Nebojsa44/Instrumented-platform/SOLID/0.0.459.26.sldasm

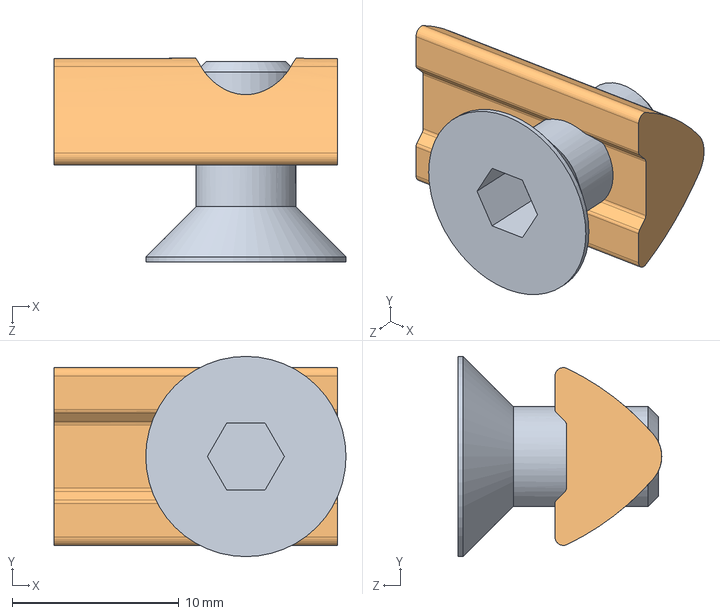
[picture p1: CAD file, 2019-02-13]
SOLID/0.0.459.26.sldasm
17.5 x 12.0 x 12.2 mm
