Nebojsa44/Instrumented-platform/SOLID/Hand.SLDASM

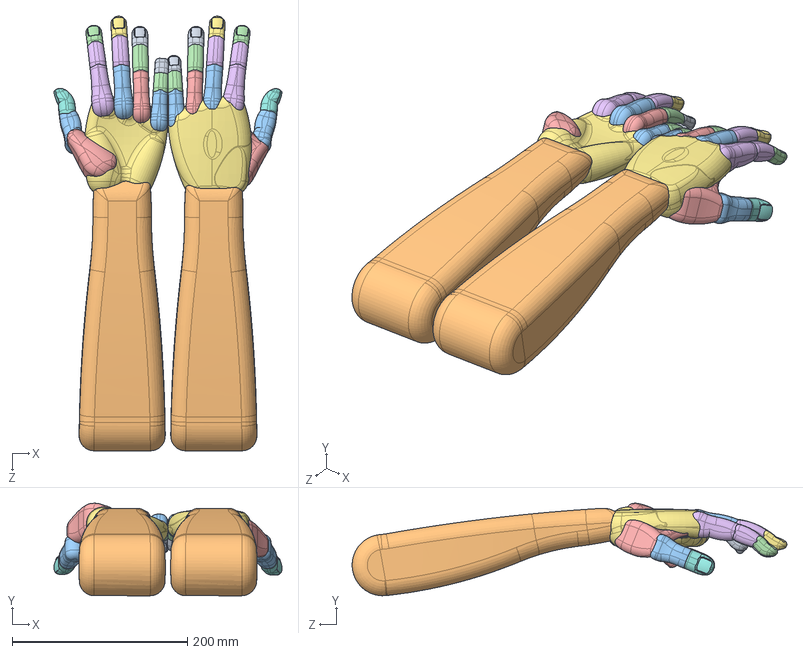
[picture p2: CAD file, 2019-02-13]
SOLID/Hand.SLDASM
260.0 x 105.6 x 495.8 mm
Kugelgelenk-Z_Standard x 2
Kugelgelenk-M_Standard x 2
D2_Standard x 2
Z1_Standard x 2
R3_Standard x 2
Z2_Standard x 2
HF-5d_Standard x 2
Kugelgelenk-R_Standard x 2
K1_Standard x 2
Unterarm-V2_Standard x 2
K3_Standard x 2
K2_Standard x 2
D3d_Standard x 2
M2_Standard x 2
Kugelgelenk-H_Standard x 2
D1_Standard x 2
R1_Standard x 2
Kugelgelenk-K_Standard x 2
M3_Standard x 2
R2_Standard x 2
Kugelgelenk-D_Standard x 2
Z3_Standard x 2
M1_Standard x 2
