Nebojsa44/Instrumented-platform/SOLID/O-1637-016.SLDASM

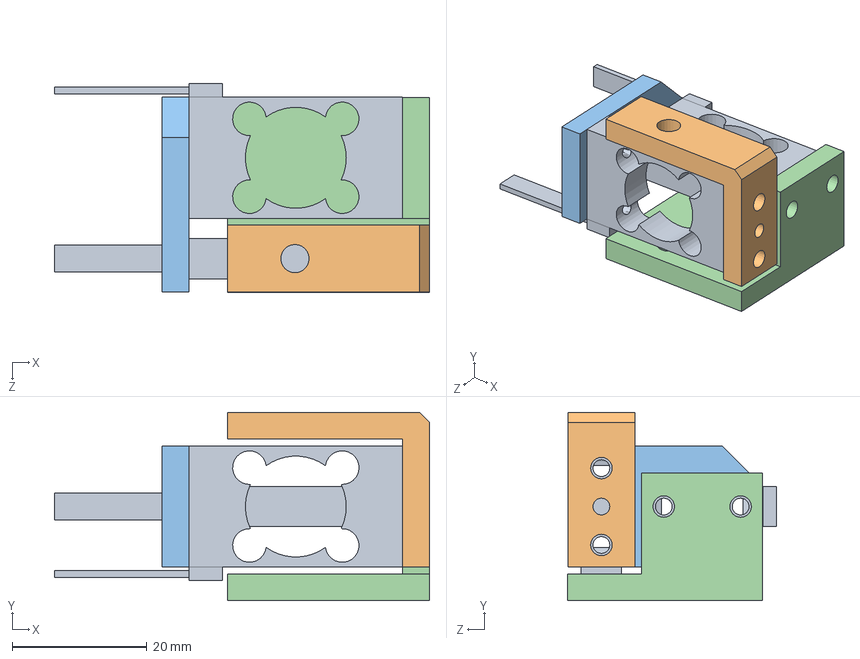
[picture p3: CAD file, 2019-02-13]
SOLID/O-1637-016.SLDASM
55.8 x 28.0 x 31.0 mm
SMD2387-M2-100 x 2
O-1637-004
O-1637-015
O-1637-017
