Nebojsa44/Instrumented-platform/SOLID/O-1637-010.SLDASM

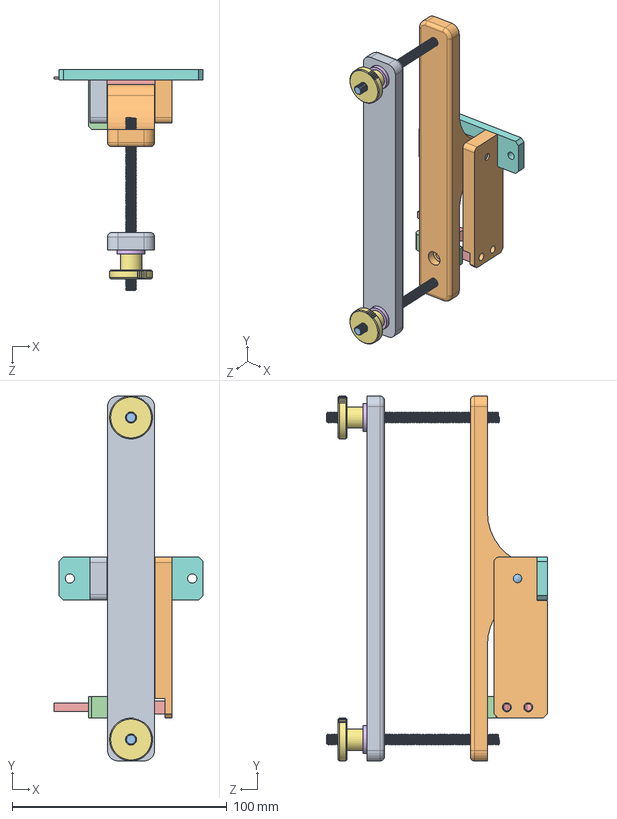
[picture p4: CAD file, 2019-02-13]
SOLID/O-1637-010.SLDASM
69.4 x 170.0 x 103.0 mm
O-1637-012
O-1637-013
GS A4 M5 x 2
O-1637-021
SMD2387-M2-500
DIN172_5-20x10x10 x 2
DIN466_A2_M5 x 2
O-1637-022
O-1637-023
O-1637-024
DIN7_4x36
