Nebojsa44/Instrumented-platform/SOLID/O-1637-007.SLDASM

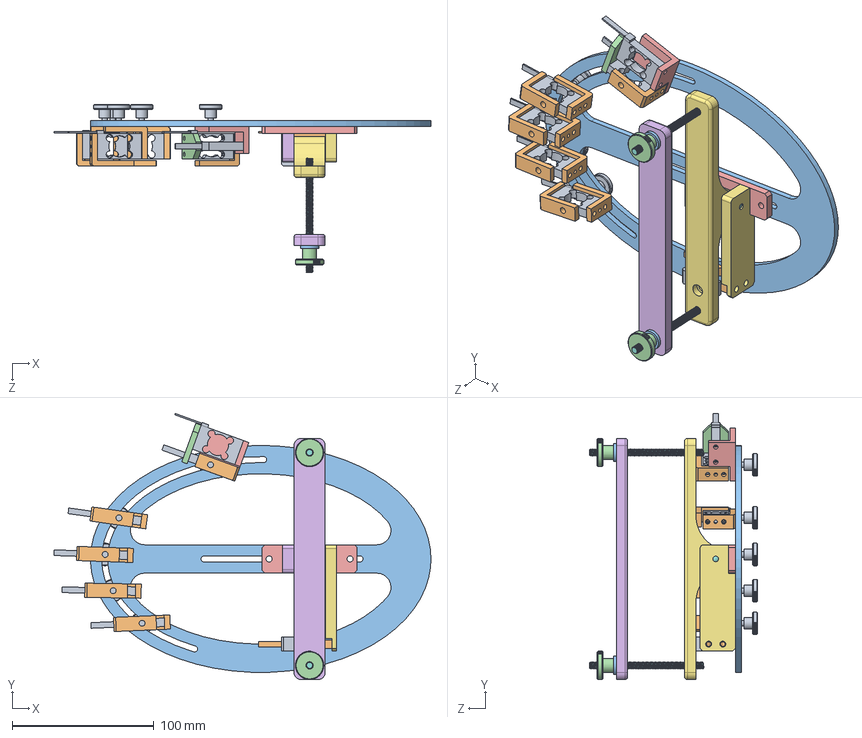
[picture p5: CAD file, 2019-02-13]
SOLID/O-1637-007.SLDASM
265.7 x 187.5 x 118.5 mm
SMD2387-M2-100 x 6
O-1637-004 x 9
O-1637-005
O-1637-015
O-1637-017
O-1637-012
O-1637-013
GS A4 M5 x 2
O-1637-021
SMD2387-M2-500
DIN172_5-20x10x10 x 2
DIN466_A2_M5 x 2
O-1637-022
O-1637-023
O-1637-024
DIN7_4x36
DIN464_A2_M4x8 x 5
