Nebojsa44/Instrumented-platform/SOLID/O-1637-018.SLDASM

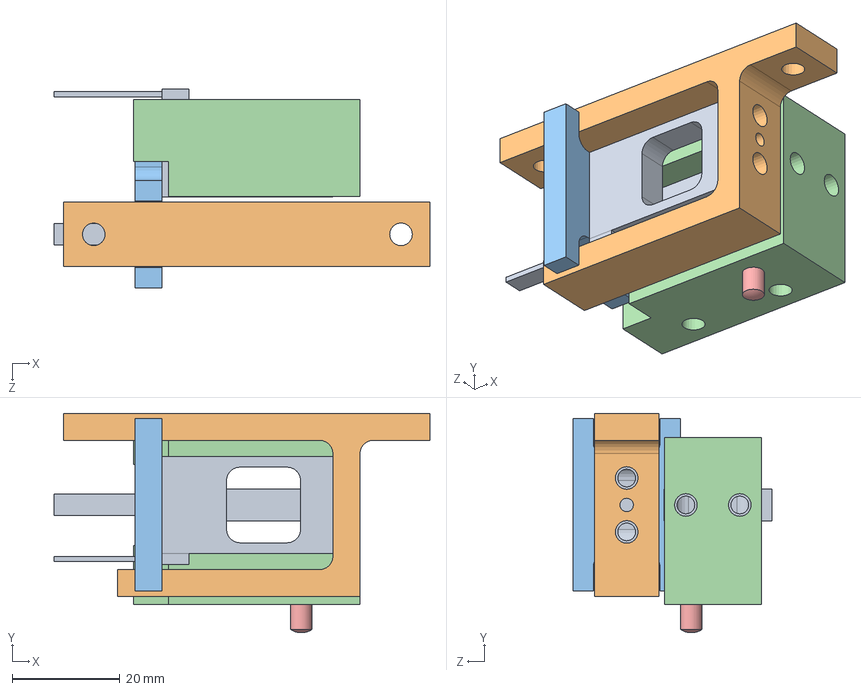
[picture p6: CAD file, 2019-02-13]
SOLID/O-1637-018.SLDASM
69.8 x 40.7 x 37.0 mm
SMD2387-M2-500 x 2
O-1637-014
O-1637-020
O-1637-019
DIN7_4x10
