Nebojsa44/Instrumented-platform/SOLID/O-1637-001.SLDASM

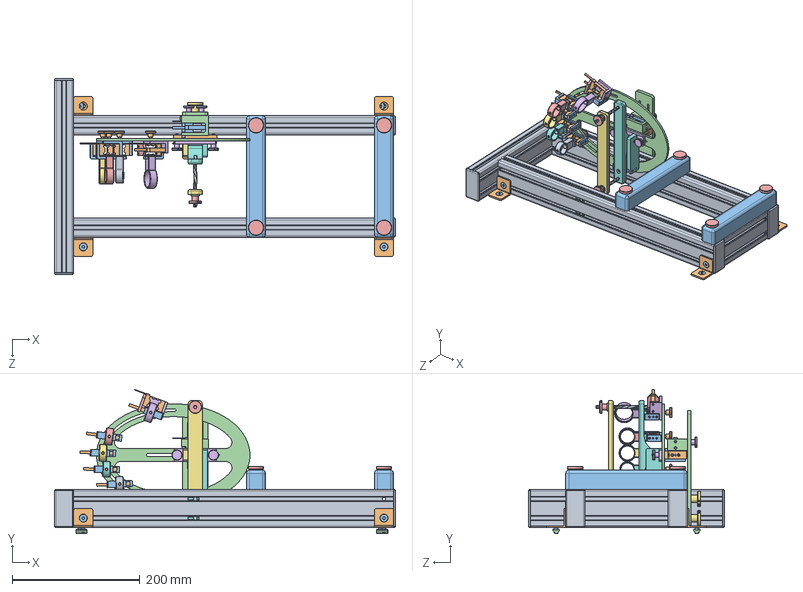
[picture p7: CAD file, 2019-02-13]
SOLID/O-1637-001.SLDASM
533.0 x 225.3 x 306.0 mm
O-1637-002
SMD2387-M2-100 x 6
O-1637-004 x 9
O-1637-005
O-1637-015
O-1637-017
O-1637-012
O-1637-013
GS A4 M5 x 2
O-1637-021
SMD2387-M2-500 x 3
DIN172_5-20x10x10 x 2
DIN466_A2_M5 x 2
O-1637-022
O-1637-023
O-1637-024
DIN7_4x36
DIN464_A2_M4x8 x 5
O-1637-008 x 2
O-1637-009
O-1637-026
O-1637-006
O-1637-027
O-1637-028
O-1637-029
O-1637-014
O-1637-020
O-1637-019
DIN7_4x10
DIN464_A2_M4x16 x 4
DIN464_A2_M6x16 x 2
DIN464_A2_M6x30 x 4
