Nebojsa44/Instrumented-platform/SOLID/O-1637-003.SLDASM

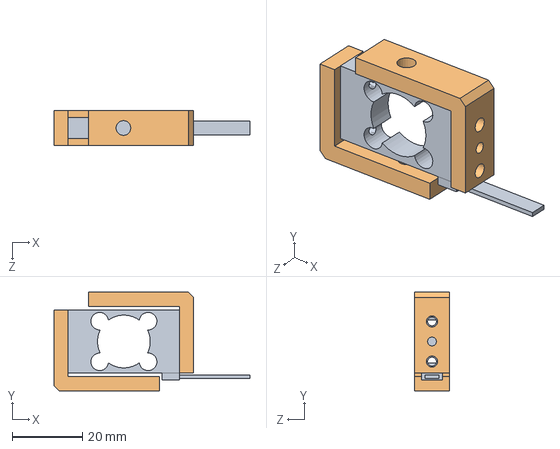
[picture p8: CAD file, 2019-02-13]
SOLID/O-1637-003.SLDASM
55.8 x 28.0 x 10.0 mm
SMD2387-M2-100
O-1637-004 x 2
