Nebojsa44/Instrumented-platform/SOLID/O-1637-025.SLDASM

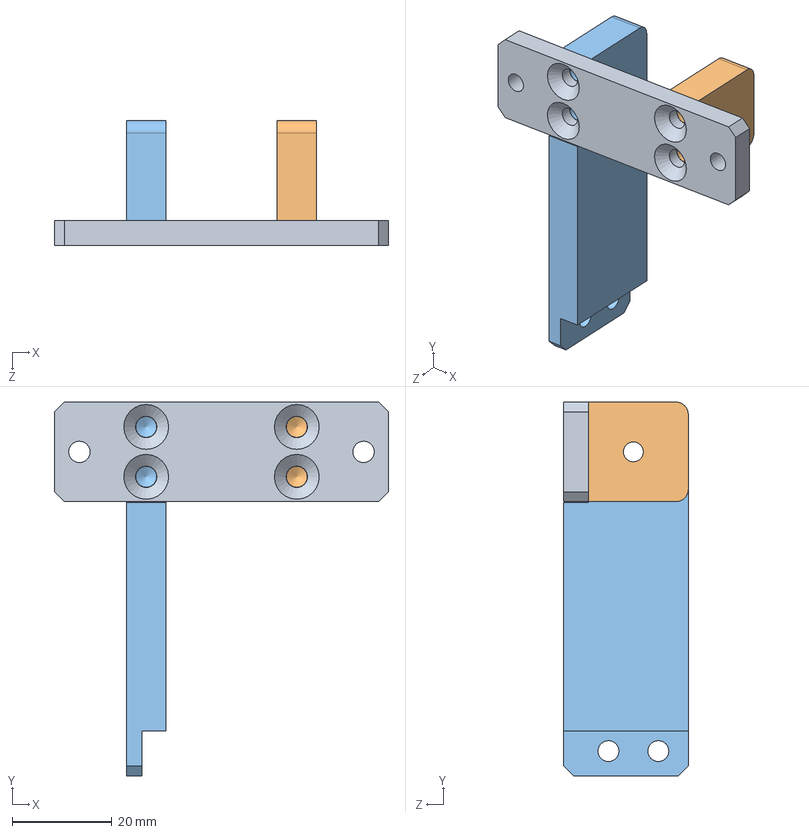
[picture p9: CAD file, 2019-02-13]
SOLID/O-1637-025.SLDASM
67.0 x 75.0 x 25.0 mm
O-1637-022
O-1637-023
O-1637-024
