Nebojsa44/Instrumented-platform/SOLID/GS A4 M5.SLDPRT

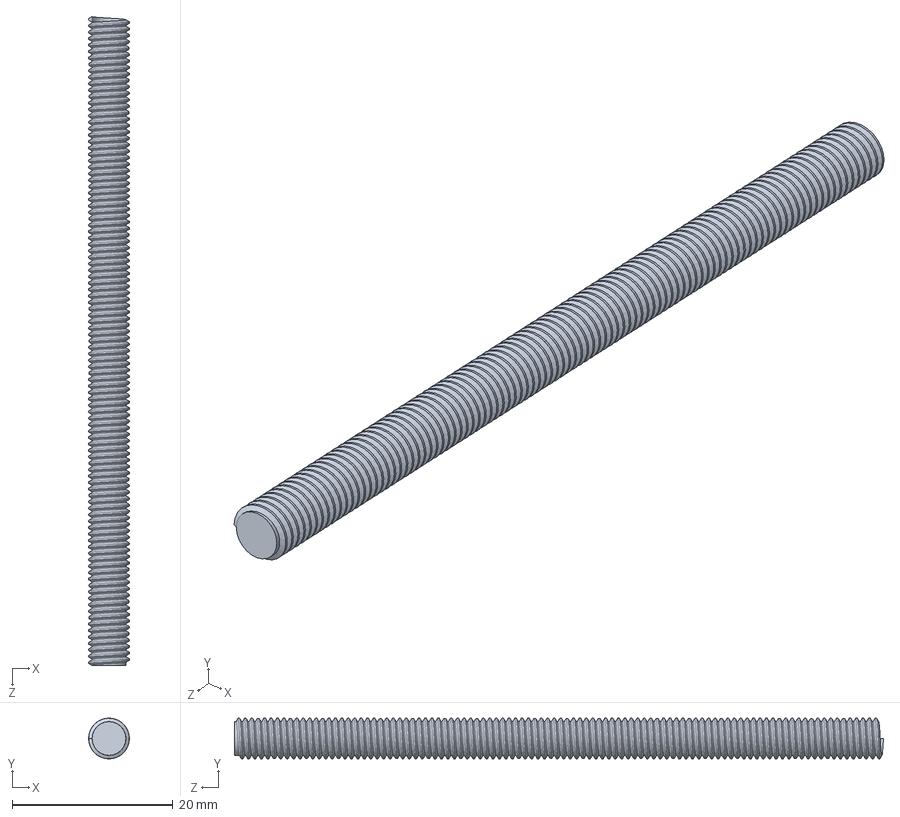
[picture p10: CAD file, 2019-02-13]
SOLID/GS A4 M5.SLDPRT
5.07 x 5.07 x 80.7 mm
