Nebojsa44/Instrumented-platform/SOLID/0.0.419.40.sldprt

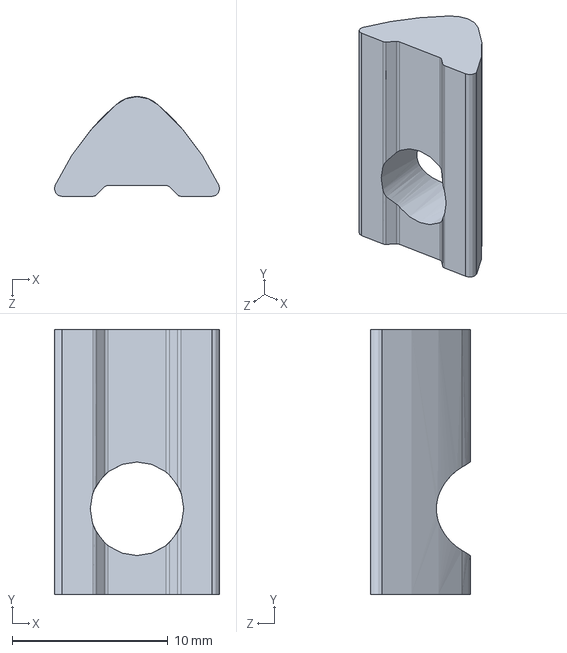
[picture p11: CAD file, 2019-02-13]
SOLID/0.0.419.40.sldprt
10.6 x 17.0 x 6.40 mm
