Nebojsa44/Instrumented-platform/SOLID/0.0.419.23.sldprt

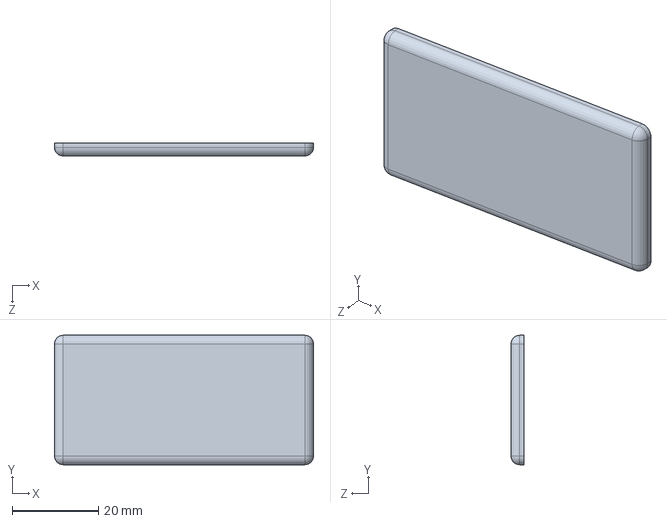
[picture p12: CAD file, 2019-02-13]
SOLID/0.0.419.23.sldprt
60.0 x 30.0 x 3.00 mm
