Nebojsa44/Instrumented-platform/SOLID/SMD2387-M2-100.SLDPRT

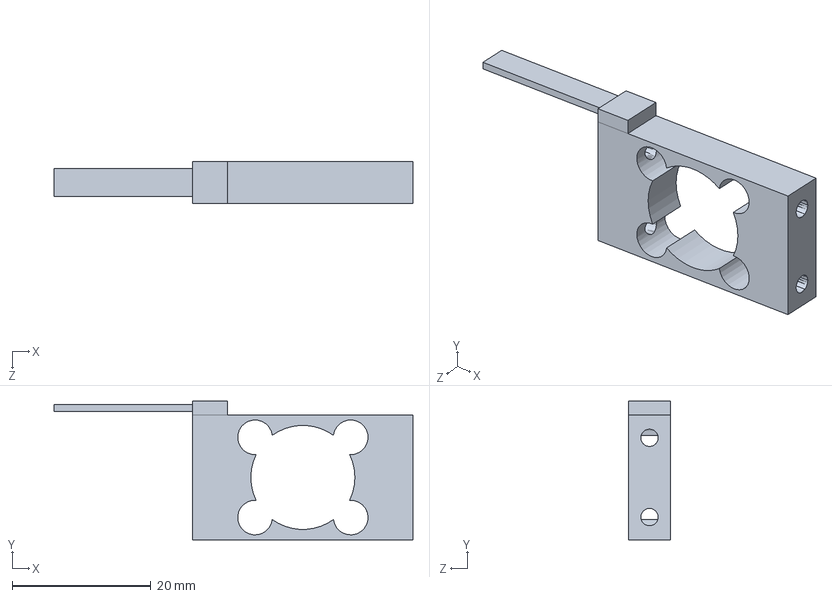
[picture p13: CAD file, 2019-02-13]
SOLID/SMD2387-M2-100.SLDPRT
51.8 x 20.0 x 5.99 mm
