Nebojsa44/Instrumented-platform/SOLID/SMD2387-M2-500.SLDPRT

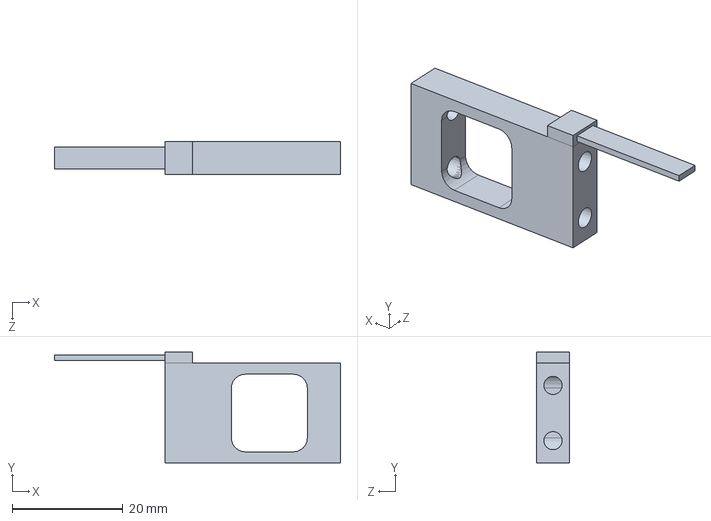
[picture p14: CAD file, 2019-02-13]
SOLID/SMD2387-M2-500.SLDPRT
51.8 x 20.0 x 5.99 mm
