Nebojsa44/Instrumented-platform/SOLID/0.0.459.12.sldprt

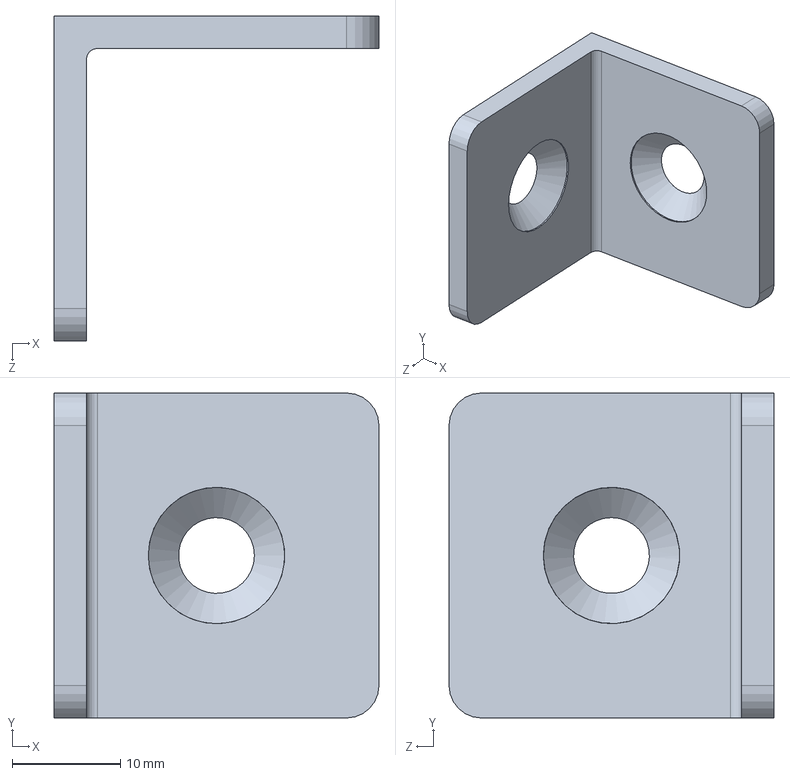
[picture p15: CAD file, 2019-02-13]
SOLID/0.0.459.12.sldprt
30.0 x 30.0 x 30.0 mm
