Nebojsa44/Instrumented-platform/SOLID/DIN7_4x10.SLDPRT

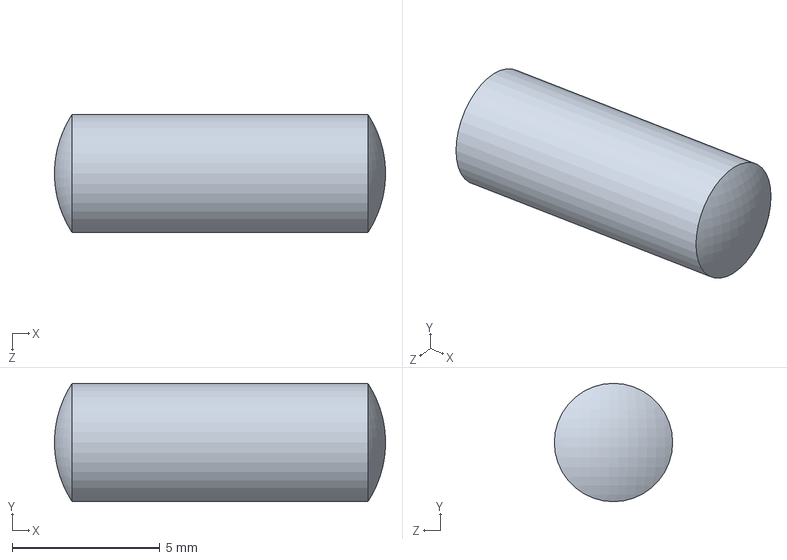
[picture p16: CAD file, 2019-02-13]
SOLID/DIN7_4x10.SLDPRT
11.2 x 4.00 x 4.00 mm
