Nebojsa44/Instrumented-platform/SOLID/DIN7_4x36.SLDPRT

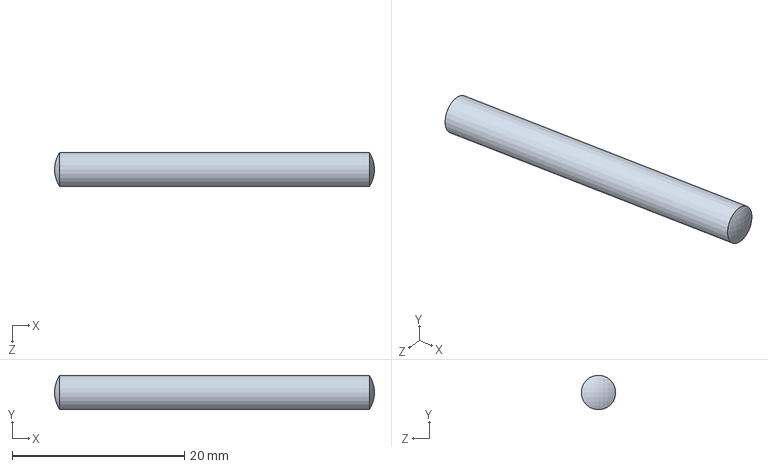
[picture p17: CAD file, 2019-02-13]
SOLID/DIN7_4x36.SLDPRT
37.2 x 4.00 x 4.00 mm
