Nebojsa44/Instrumented-platform/SOLID/O-1637-022.SLDPRT

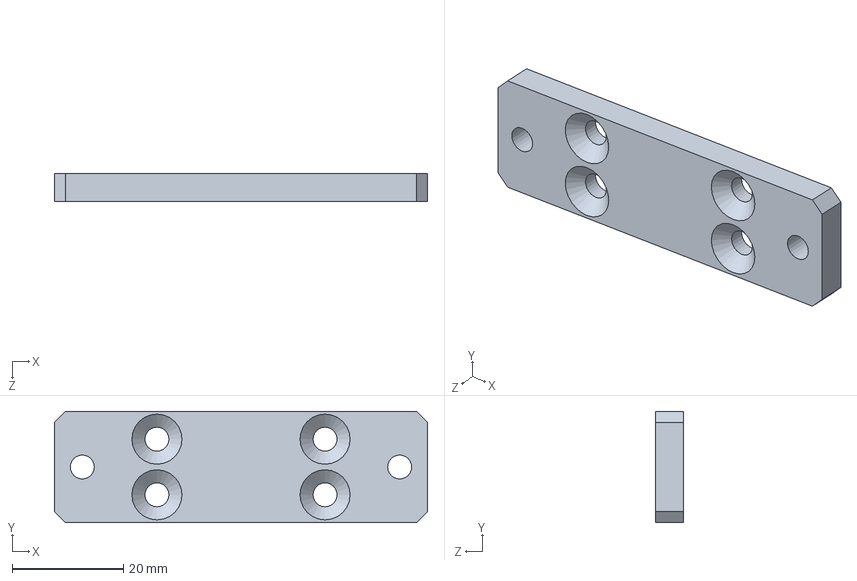
[picture p18: CAD file, 2019-02-13]
SOLID/O-1637-022.SLDPRT
67.0 x 20.0 x 5.00 mm
