Nebojsa44/Instrumented-platform/SOLID/O-1637-019.SLDPRT

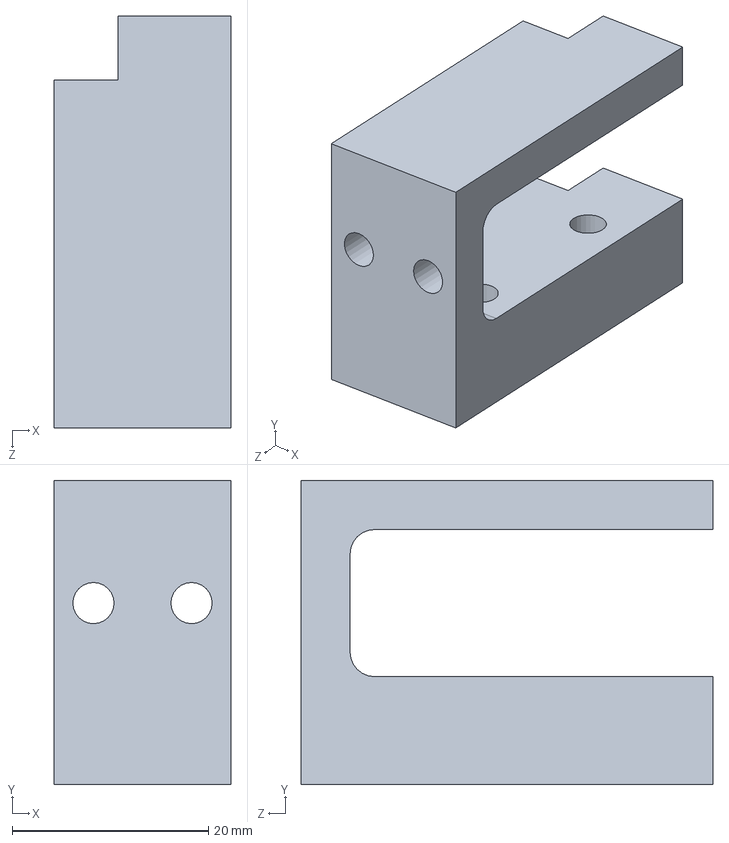
[picture p19: CAD file, 2019-02-13]
SOLID/O-1637-019.SLDPRT
18.0 x 31.0 x 42.0 mm
