Nebojsa44/Instrumented-platform/SOLID/O-1637-012.SLDPRT

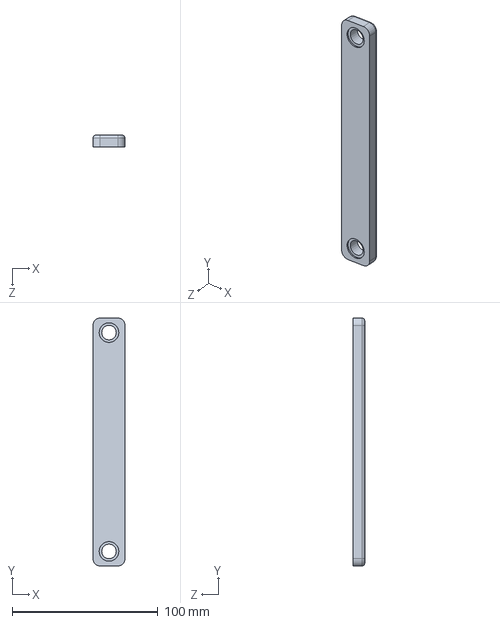
[picture p20: CAD file, 2019-02-13]
SOLID/O-1637-012.SLDPRT
22.0 x 170.0 x 8.00 mm
