Nebojsa44/Instrumented-platform/SOLID/O-1637-021.SLDPRT

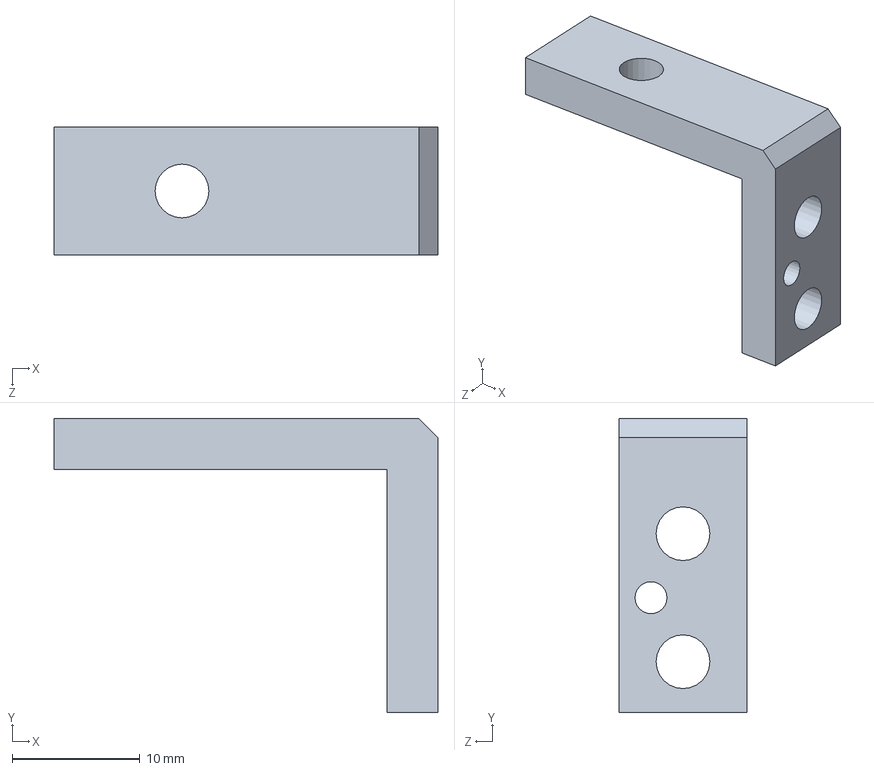
[picture p21: CAD file, 2019-02-13]
SOLID/O-1637-021.SLDPRT
30.0 x 23.0 x 10.0 mm
