Nebojsa44/Instrumented-platform/SOLID/O-1637-023.SLDPRT

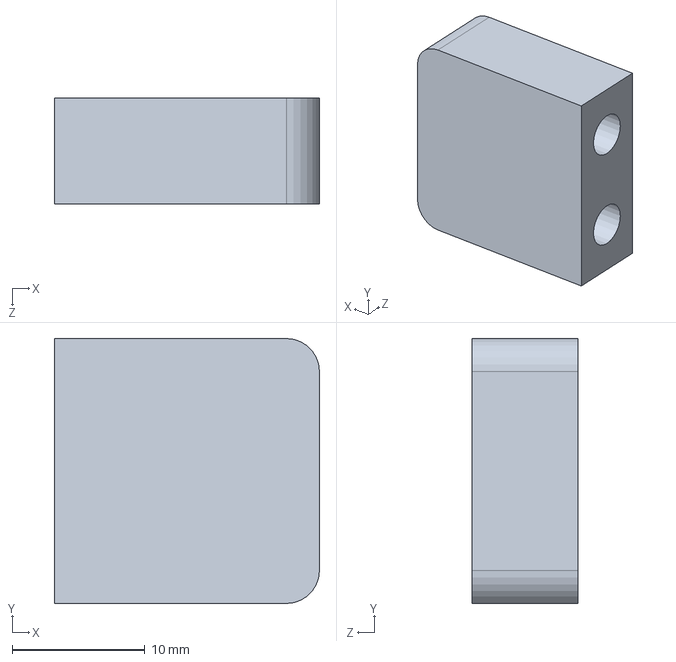
[picture p22: CAD file, 2019-02-13]
SOLID/O-1637-023.SLDPRT
20.0 x 20.0 x 8.00 mm
