Nebojsa44/Instrumented-platform/SOLID/O-1637-015.SLDPRT

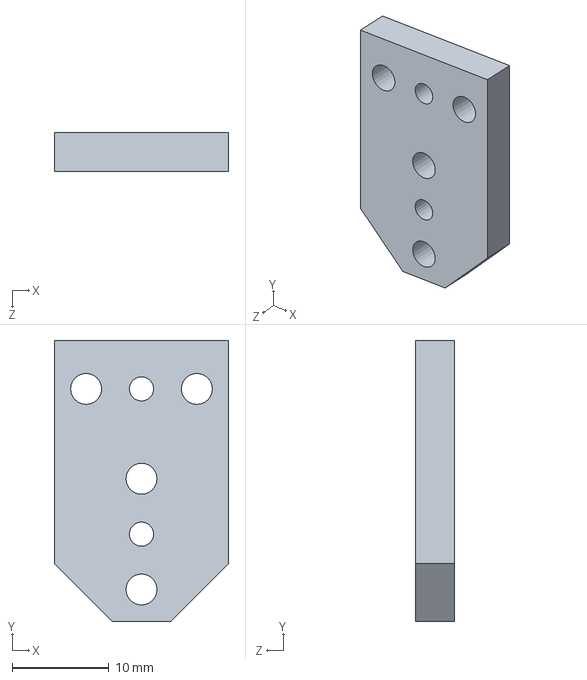
[picture p23: CAD file, 2019-02-13]
SOLID/O-1637-015.SLDPRT
18.0 x 29.0 x 4.00 mm
