Nebojsa44/Instrumented-platform/SOLID/O-1637-037.SLDPRT

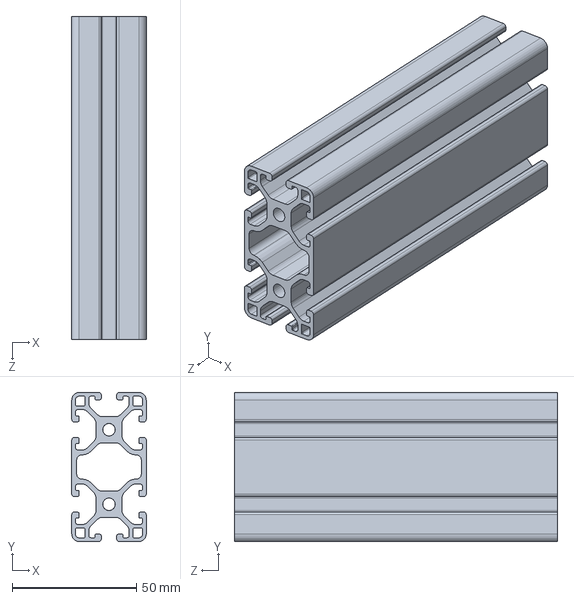
[picture p24: CAD file, 2019-02-13]
SOLID/O-1637-037.SLDPRT
30.0 x 60.0 x 130.0 mm
