Nebojsa44/Instrumented-platform/SOLID/O-1637-035.SLDPRT

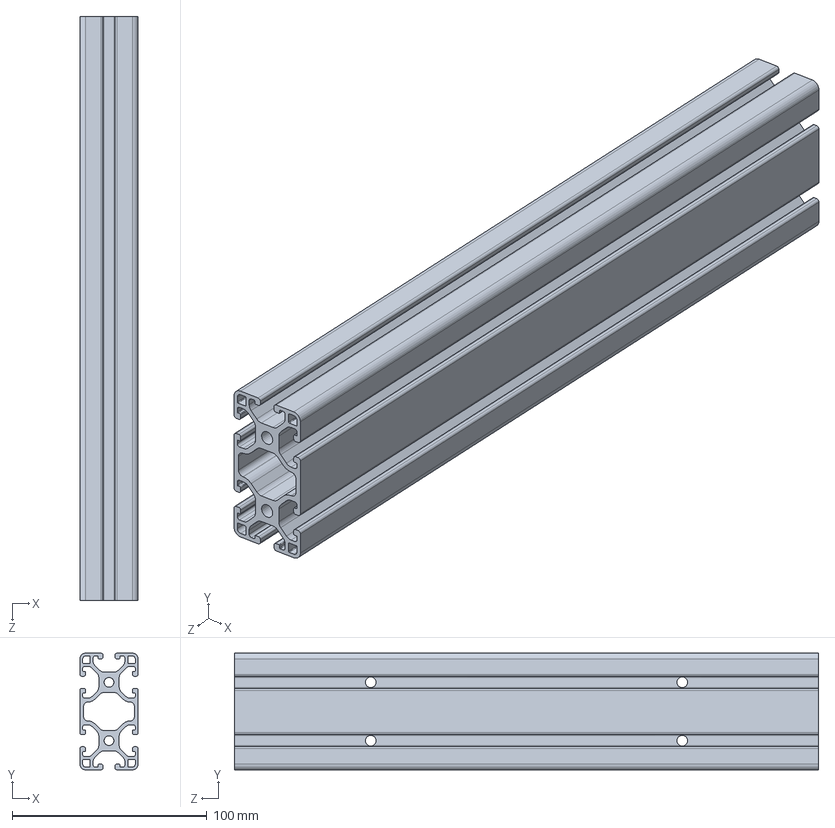
[picture p25: CAD file, 2019-02-13]
SOLID/O-1637-035.SLDPRT
30.0 x 60.0 x 300.0 mm
