Nebojsa44/Instrumented-platform/SOLID/O-1637-036.SLDPRT

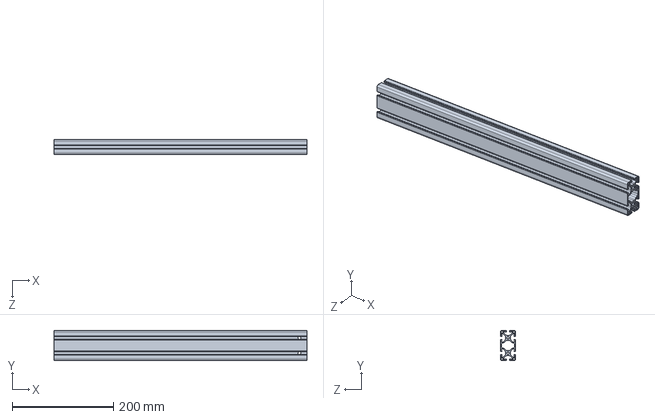
[picture p26: CAD file, 2019-02-13]
SOLID/O-1637-036.SLDPRT
500.0 x 60.0 x 30.0 mm
