Nebojsa44/Instrumented-platform/SOLID/O-1637-005.SLDPRT

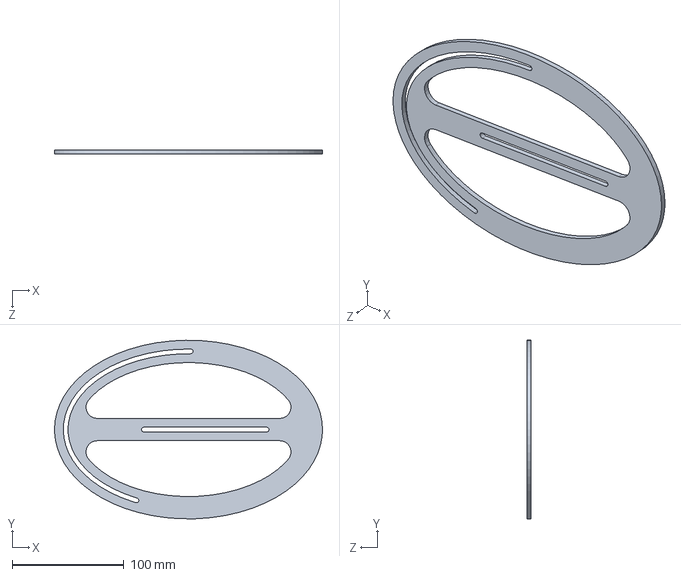
[picture p27: CAD file, 2019-02-13]
SOLID/O-1637-005.SLDPRT
240.0 x 159.9 x 4.00 mm
