Nebojsa44/Instrumented-platform/SOLID/O-1637-013.SLDPRT

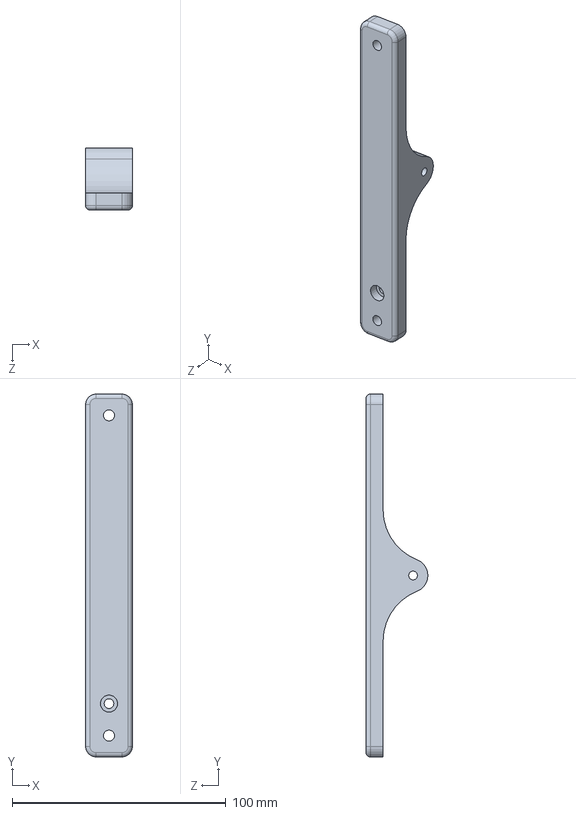
[picture p28: CAD file, 2019-02-13]
SOLID/O-1637-013.SLDPRT
22.0 x 170.0 x 29.0 mm
