Nebojsa44/Instrumented-platform/SOLID/O-1637-002.SLDPRT

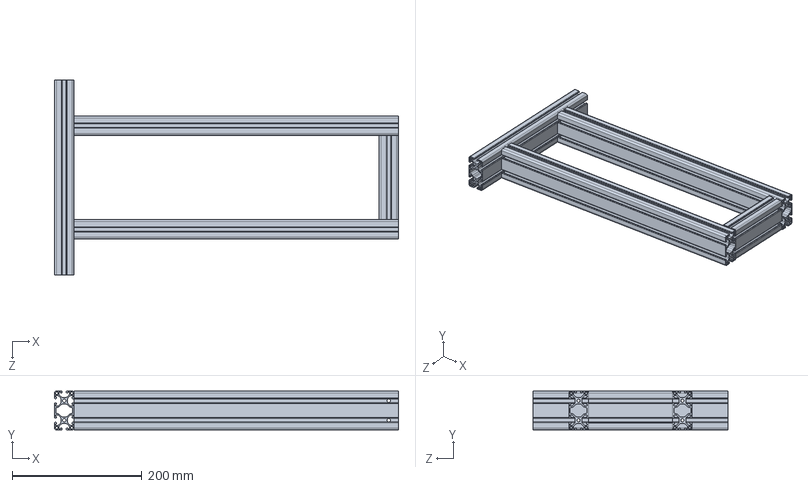
[picture p29: CAD file, 2019-02-13]
SOLID/O-1637-002.SLDPRT
530.0 x 60.0 x 300.0 mm
