Nebojsa44/Instrumented-platform/SOLID/O-1637-017.SLDPRT

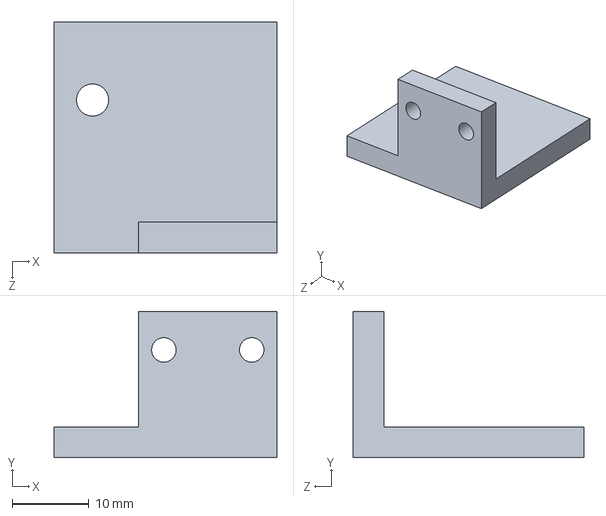
[picture p30: CAD file, 2019-02-13]
SOLID/O-1637-017.SLDPRT
29.0 x 19.0 x 30.0 mm
