Nebojsa44/Instrumented-platform/SOLID/O-1637-008.SLDPRT

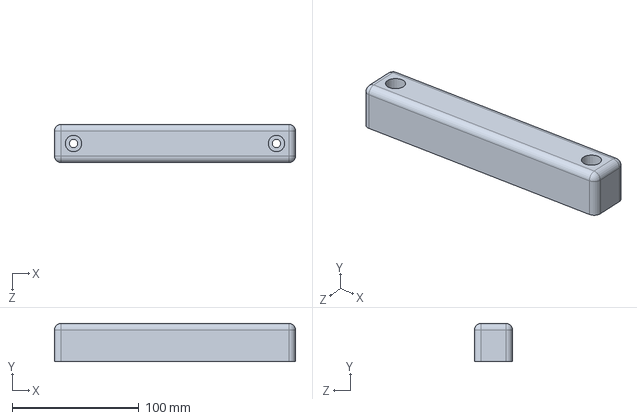
[picture p31: CAD file, 2019-02-13]
SOLID/O-1637-008.SLDPRT
190.0 x 30.0 x 30.0 mm
