Nebojsa44/Instrumented-platform/SOLID/O-1637-024.SLDPRT

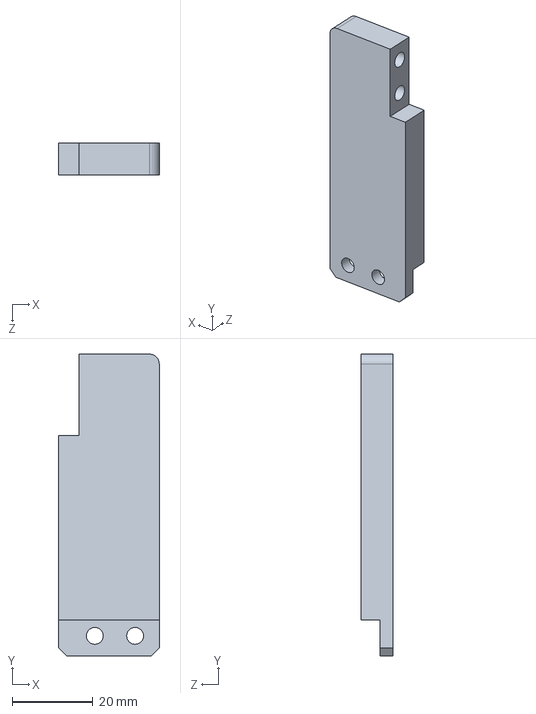
[picture p32: CAD file, 2019-02-13]
SOLID/O-1637-024.SLDPRT
25.0 x 75.0 x 8.00 mm
