Nebojsa44/Instrumented-platform/(list of files, cad)

Other CAD files:
SOLID/K2_Standard.sldprt
SOLID/Kugelgelenk-Z_Standard.sldprt
SOLID/Z2_Standard.sldprt
SOLID/M2_Standard.sldprt
SOLID/R2_Standard.sldprt
SOLID/R1_Standard.sldprt
SOLID/Z3_Standard.sldprt
SOLID/D1_Standard.sldprt
SOLID/0.0.459.26_1.sldprt
SOLID/Z1_Standard.sldprt
SOLID/Kugelgelenk-K_Standard.sldprt
SOLID/K1_Standard.sldprt
SOLID/Kugelgelenk-M_Standard.sldprt
SOLID/M1_Standard.sldprt
SOLID/Kugelgelenk-R_Standard.sldprt
SOLID/HF-5d_Standard.sldprt
SOLID/D2_Standard.sldprt
SOLID/Unterarm-V2_Standard.sldprt
SOLID/K3_Standard.sldprt
SOLID/Kugelgelenk-H_Standard.sldprt
SOLID/D3d_Standard.sldprt
SOLID/Kugelgelenk-D_Standard.sldprt
SOLID/R3_Standard.sldprt
SOLID/O-1637-004.SLDPRT
SOLID/0.0.459.26.sldprt
SOLID/DIN172_5-20x10x10.SLDPRT
SOLID/DIN464_A2_M4x16.SLDPRT
SOLID/DIN464_A2_M4x8.SLDPRT
SOLID/DIN464_A2_M6x16.SLDPRT
SOLID/DIN464_A2_M6x30.SLDPRT
SOLID/DIN466_A2_M5.SLDPRT
SOLID/O-1637-001.SLDDRW
SOLID/O-1637-002.SLDDRW
SOLID/O-1637-003.SLDDRW
SOLID/O-1637-004.SLDDRW
SOLID/O-1637-005.SLDDRW
SOLID/O-1637-006.SLDDRW
SOLID/O-1637-007.SLDDRW
SOLID/O-1637-008.SLDDRW
SOLID/O-1637-009.SLDDRW
SOLID/O-1637-010.SLDDRW
SOLID/O-1637-012.SLDDRW
SOLID/O-1637-013.SLDDRW
SOLID/O-1637-014.SLDDRW
SOLID/O-1637-015.SLDDRW
SOLID/O-1637-016.SLDDRW
SOLID/O-1637-017.SLDDRW
SOLID/O-1637-018.SLDDRW
SOLID/O-1637-019.SLDDRW
SOLID/O-1637-020.SLDDRW
SOLID/O-1637-021.SLDDRW
SOLID/O-1637-022.SLDDRW
SOLID/O-1637-023.SLDDRW
SOLID/O-1637-024.SLDDRW
SOLID/O-1637-025.SLDDRW
SOLID/O-1637-026.SLDDRW
SOLID/O-1637-027.SLDDRW
SOLID/O-1637-028.SLDDRW
SOLID/O-1637-029.SLDDRW
SOLID/O-1637-031.SLDDRW
SOLID/O-1637-032.SLDDRW
SOLID/O-1637-033.SLDDRW
SOLID/O-1637-034.SLDDRW
SOLID/O-1637-035.SLDDRW
SOLID/O-1637-036.SLDDRW
SOLID/O-1637-037.SLDDRW
