Nebojsa44/Instrumented-platform/PDF/O-1637-002.PDF

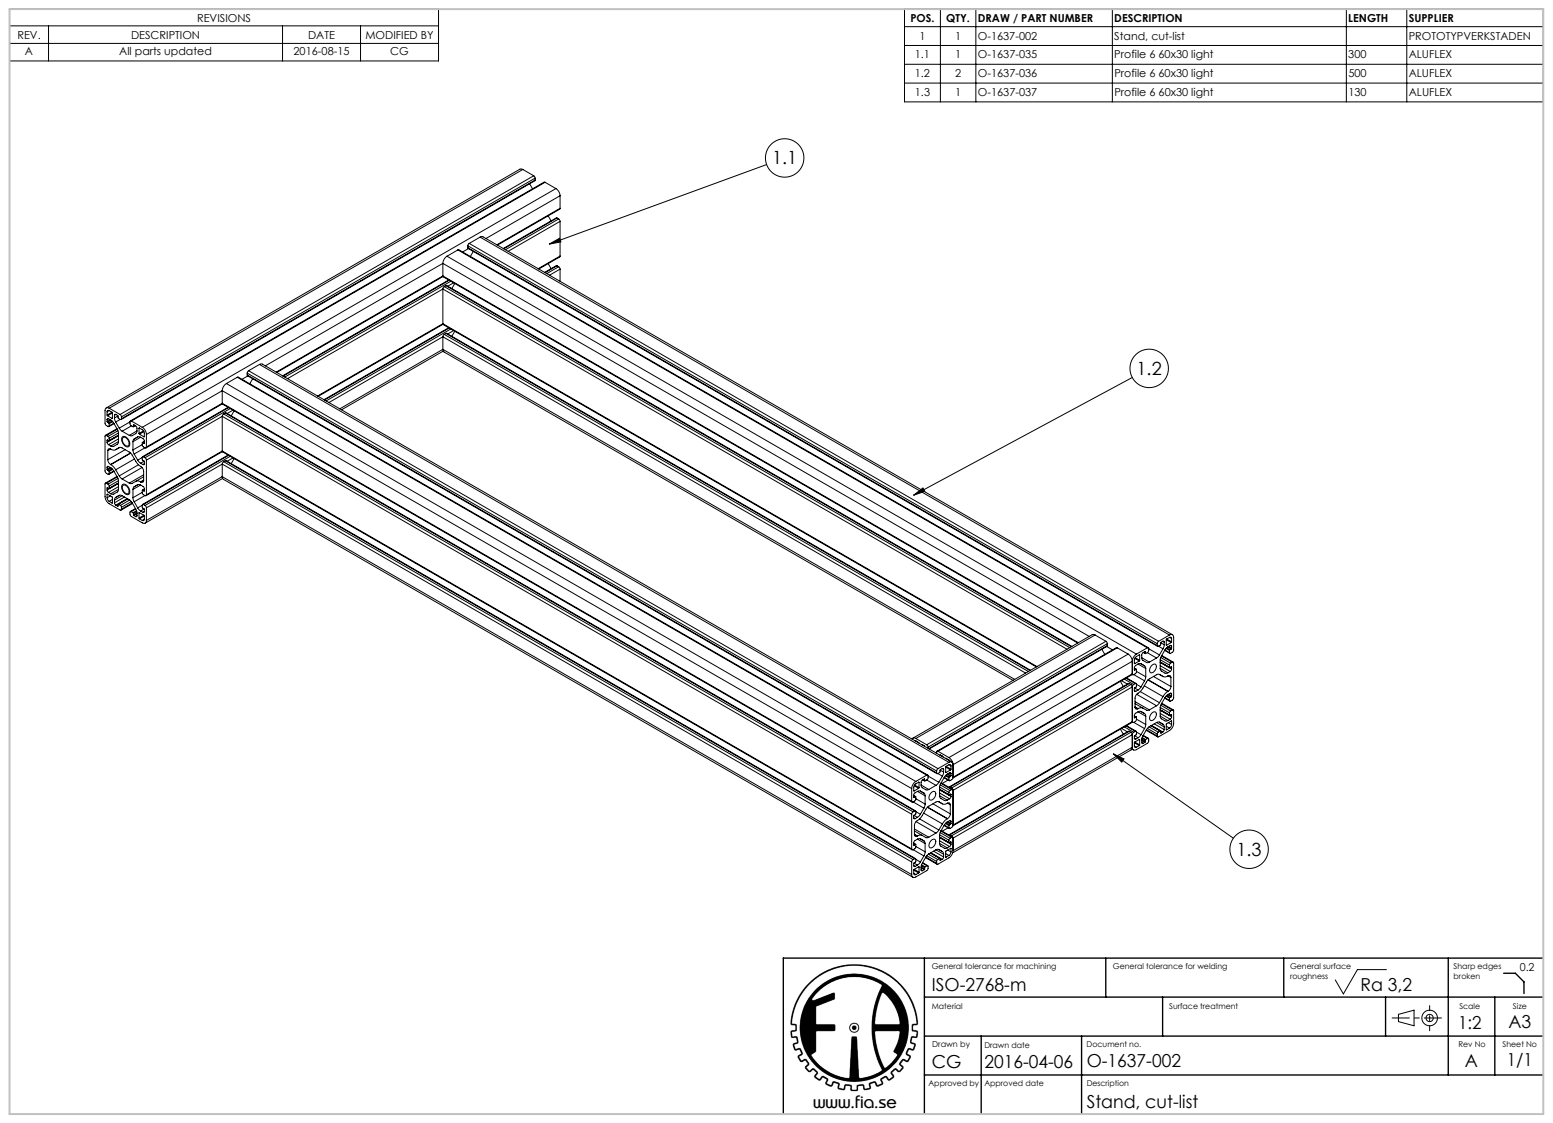
[picture p34: page 1]
Rev No; Approved by; Drawn by; Sheet No; Sharp edges; Drawn date CG 2016-04-06; Approved date; Surface treatment; General surface

REVISIONS | | POS. | QTY. | DRAW / PART NUMBER | DESCRIPTION | LENGTH | SUPPLIER

REV. | DESCRIPTION | DATE | MODIFIED BY | | 1 | 1 | O-1637-002 | Stand, cut-list | | PROTOTYPVERKSTADEN
A | All parts updated | 2016-08-15 | CG | | 1.1 | 1 | O-1637-035 | Profile 6 60x30 light | 300 | ALUFLEX

1.2 | 2 | O-1637-036 | Profile 6 60x30 light | 500 | ALUFLEX
1.3 | 1 | O-1637-037 | Profile 6 60x30 light | 130 | ALUFLEX

General tolerance for machining
ISO-2768-m

General tolerance for welding

Document no.
Stand, cut-list

www.fia.se
