Nebojsa44/Instrumented-platform/PDF/O-1637-003.PDF

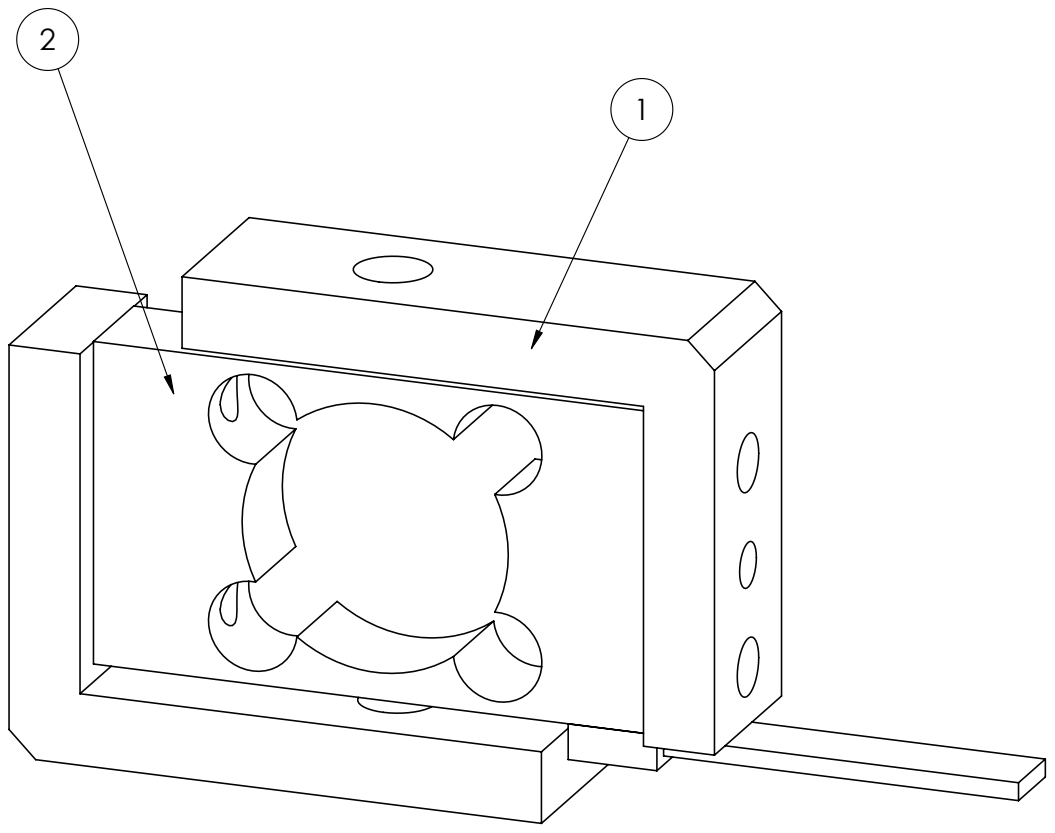
[picture p35: page 1]
Measurement unit; Rev No; Approved by; Drawn by; Sheet No; Document no.; Sharp edges; Drawn date CG 2016-04-06; Approved date; Surface treatment; General surface

POS. | QTY. | DRAW / PART NUMBER | DESCRIPTION | SUPPLIER
1 | 2 | O-1637-004 | Mounting adapter for load cell | PROTOTYPVERKSTADEN
2 | 1 | SMD2387-M2-100 | S250 and S251 - Miniature Platform Load Cell 10kg M3 | STRAIN MEASUREMENT DEVICES

General tolerance for machining
ISO-2768-m

General tolerance for welding

www.fia.se
