Nebojsa44/Instrumented-platform/PDF/O-1637-004.PDF

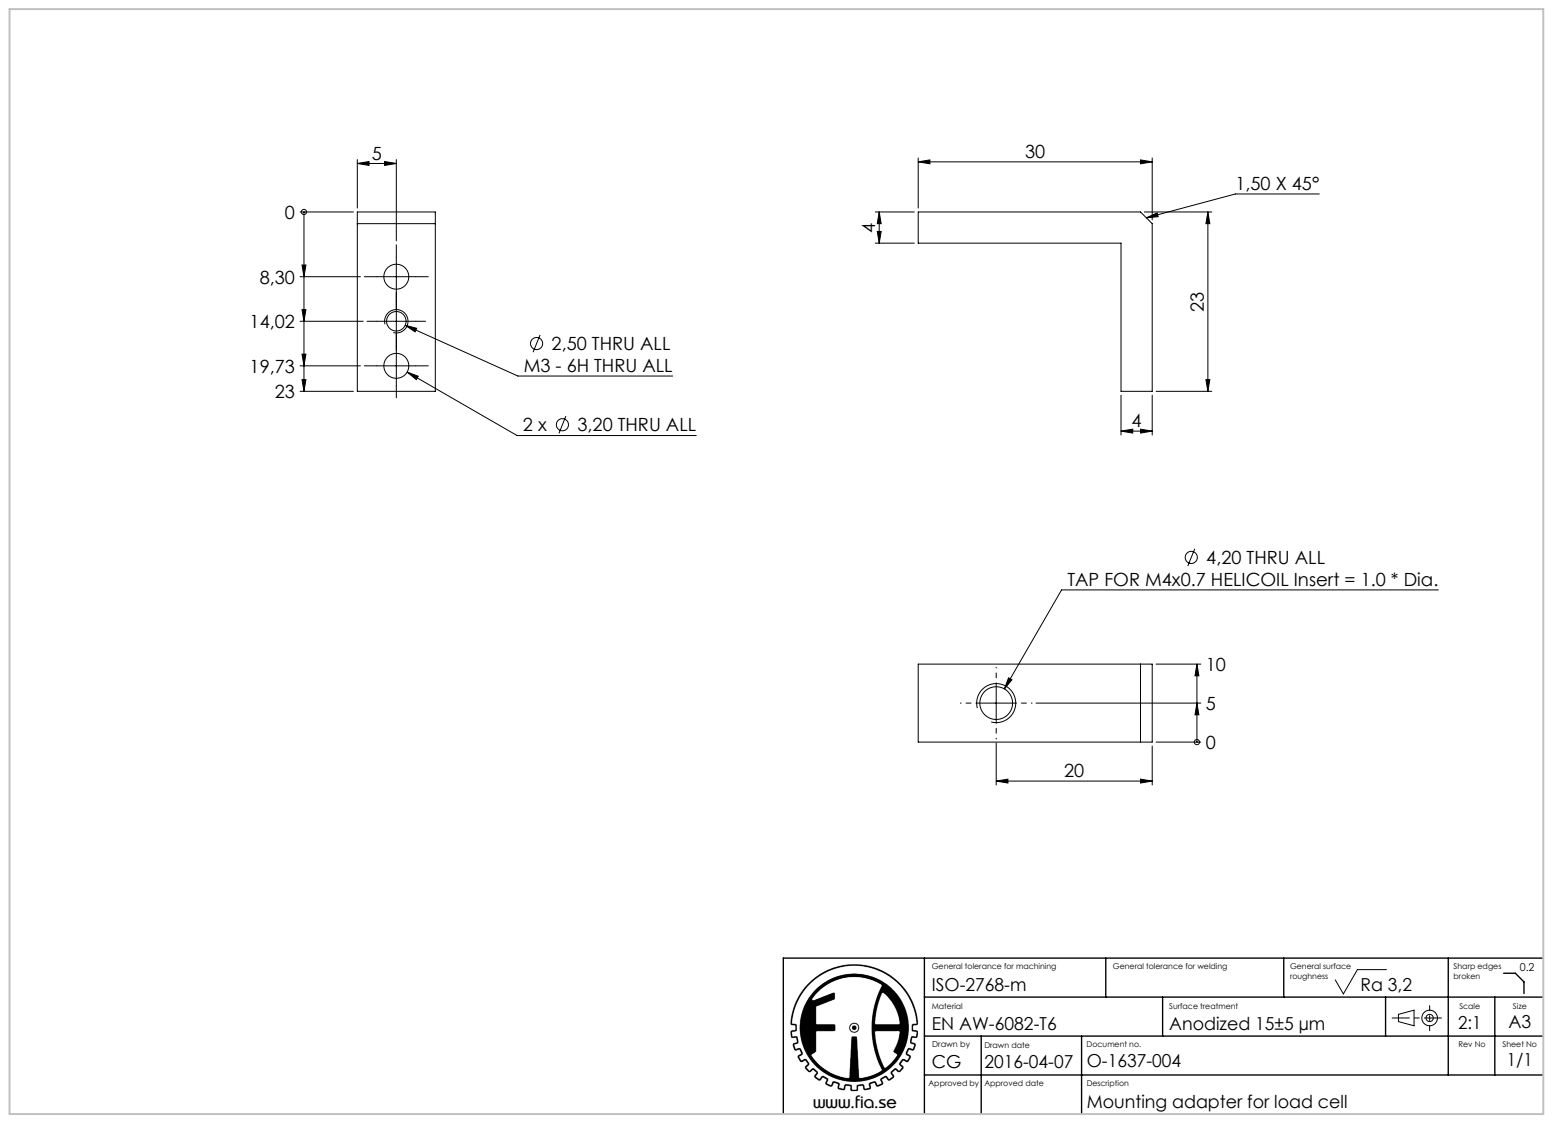
[picture p36: page 1]
3,20 THRU ALL; 2,50 THRU ALL M3 - 6H THRU ALL; 4,20 THRU ALL; Rev No; Approved by; Drawn by; Sheet No; Sharp edges; Drawn date; Approved date; Surface treatment Anodized 15±5 µm; General surface

TAP FOR M4x0.7 HELICOIL Insert = 1.0 * Dia.

General tolerance for machining
ISO-2768-m

General tolerance for welding

Document no.
Mounting adapter for load cell

www.fia.se
