Nebojsa44/Instrumented-platform/PDF/O-1637-005.PDF

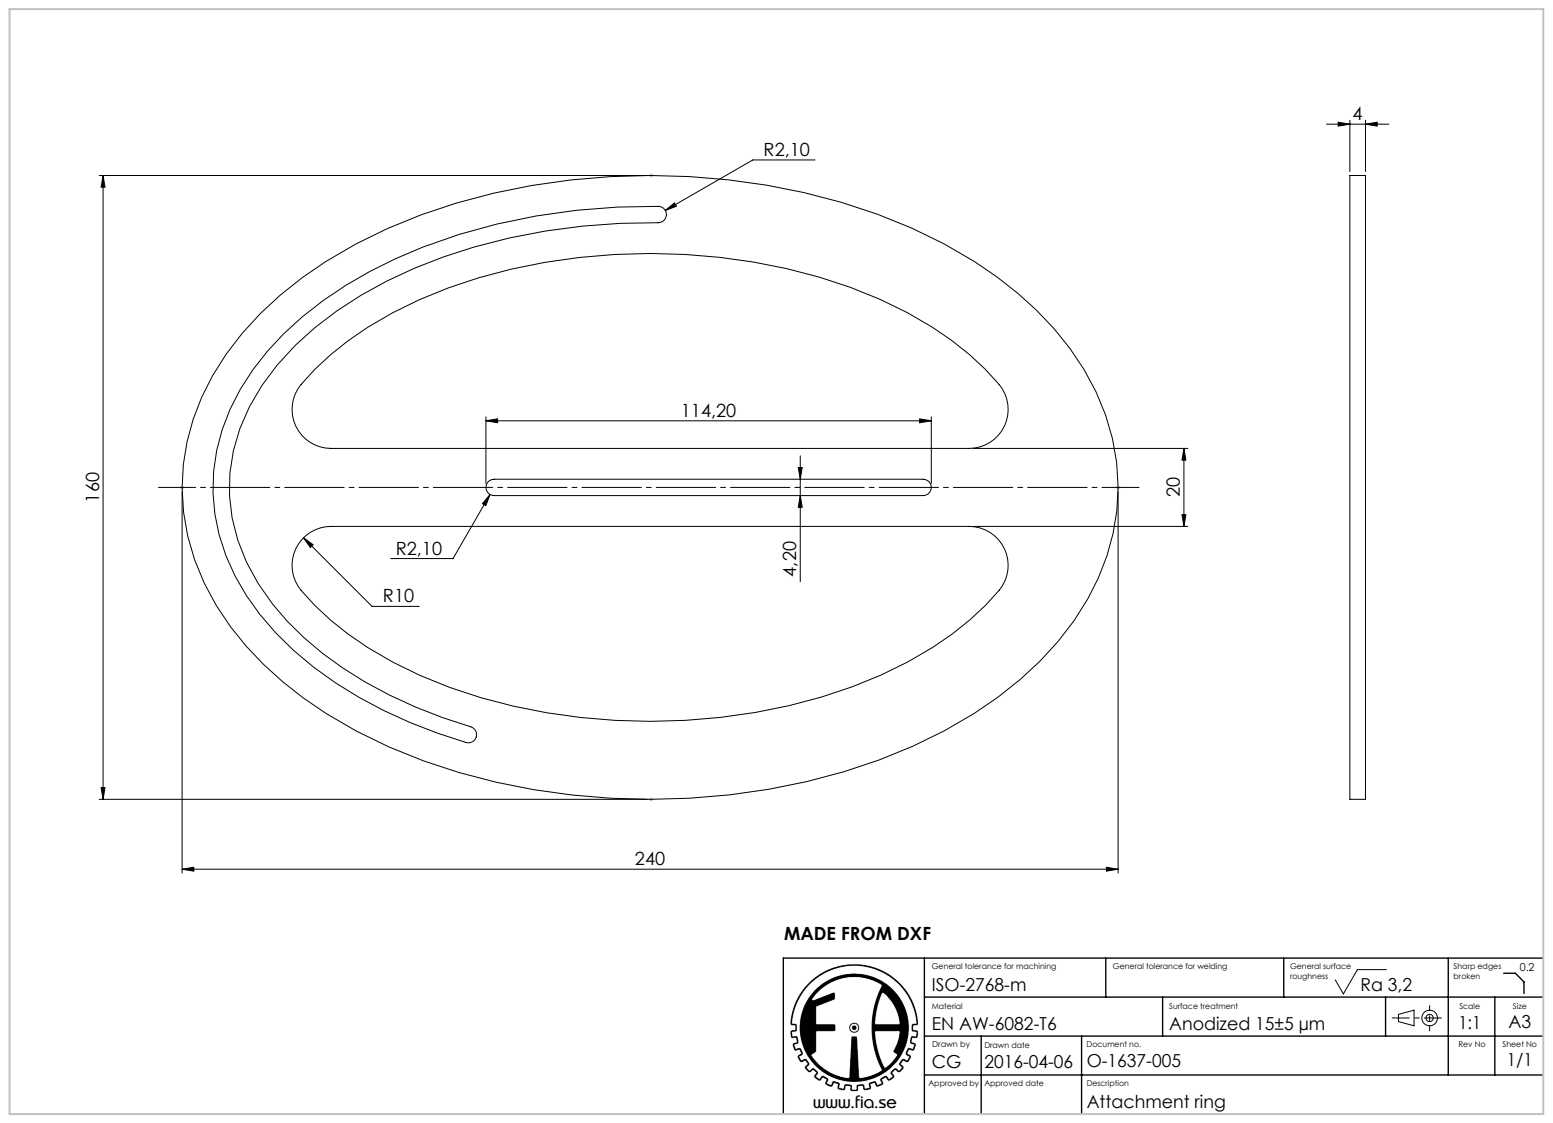
[picture p37: page 1]
Attachment ring; Rev No; Approved by; Drawn by; Sheet No; Document no.; Sharp edges; Drawn date; Approved date; Surface treatment Anodized 15±5 µm; General surface

MADE FROM DXF

General tolerance for machining
ISO-2768-m

General tolerance for welding

www.fia.se
