Nebojsa44/Instrumented-platform/PDF/O-1637-007.PDF

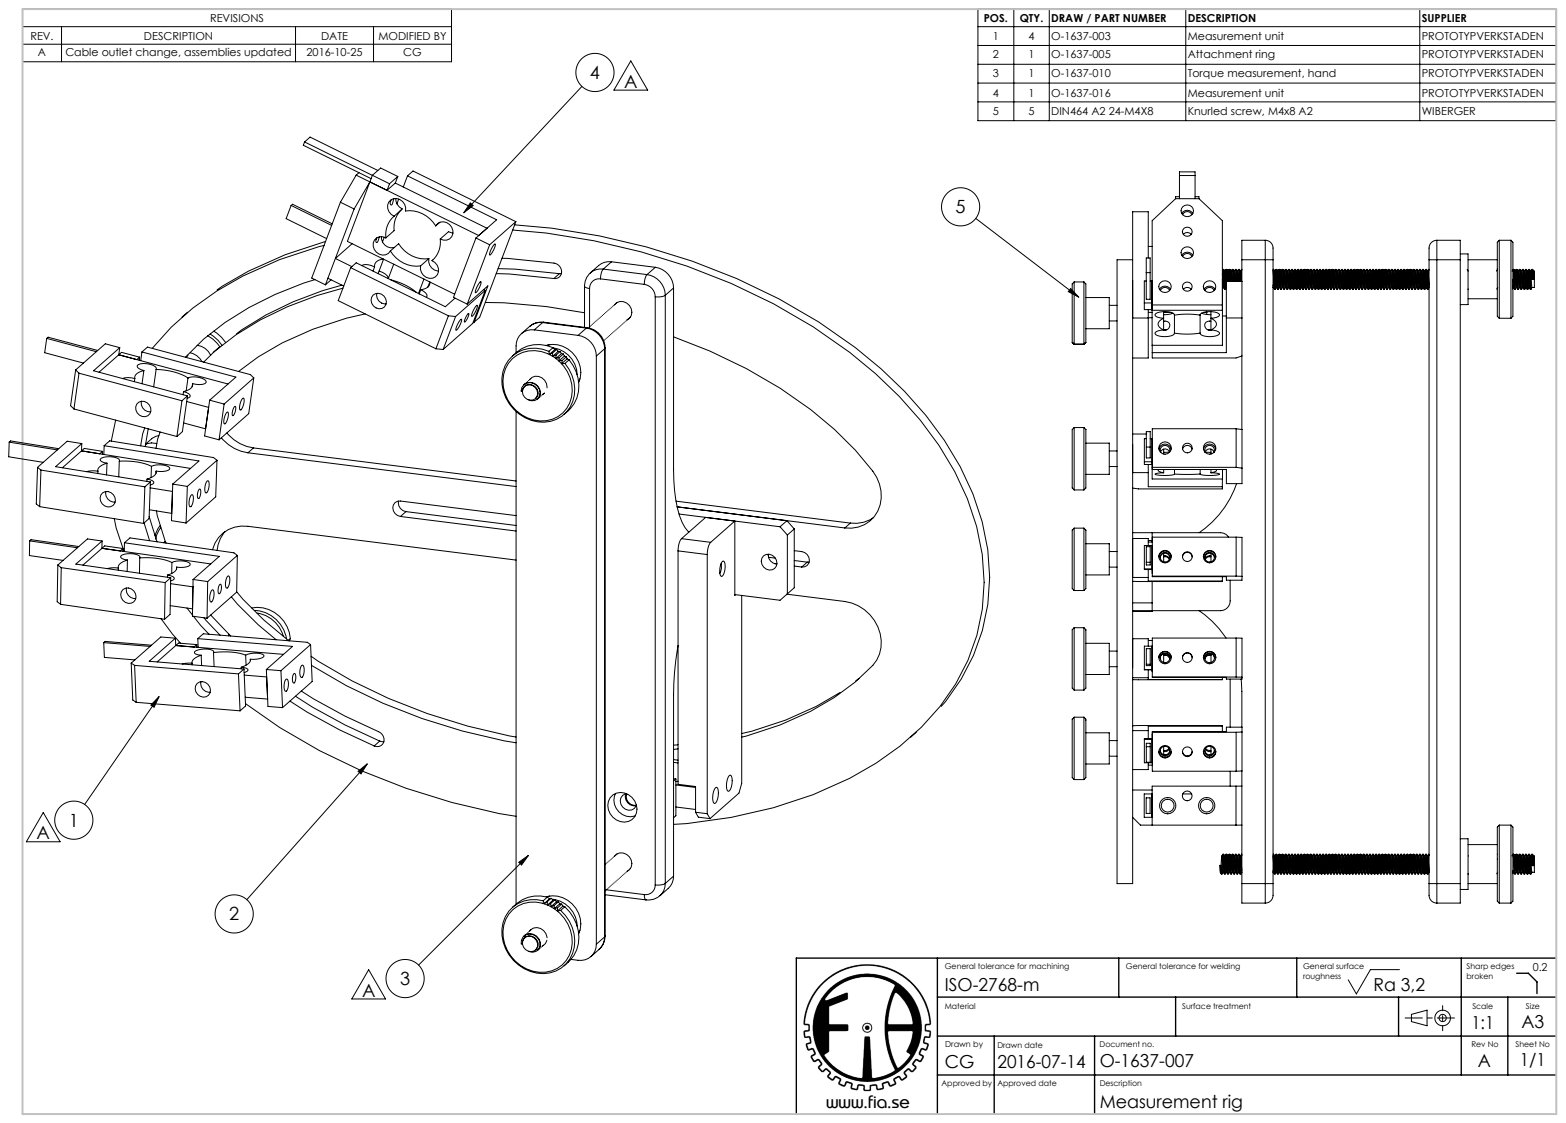
[picture p38: page 1]
Measurement rig; Rev No; Approved by; Drawn by; Sheet No; Document no.; Sharp edges; Drawn date CG 2016-07-14; Approved date; Surface treatment; General surface

REVISIONS | | POS. | QTY. | DRAW / PART NUMBER | DESCRIPTION | SUPPLIER

REV. | DESCRIPTION | DATE | MODIFIED BY | | 1 | 4 | O-1637-003 | Measurement unit | PROTOTYPVERKSTADEN
A | Cable outlet change, assemblies updated | 2016-10-25 | CG | | 2 | 1 | O-1637-005 | Attachment ring | PROTOTYPVERKSTADEN

3 | 1 | O-1637-010 | Torque measurement, hand | PROTOTYPVERKSTADEN
4 | 1 | O-1637-016 | Measurement unit | PROTOTYPVERKSTADEN
5 | 5 | DIN464 A2 24-M4X8 | Knurled screw, M4x8 A2 | WIBERGER

General tolerance for machining
ISO-2768-m

General tolerance for welding

www.fia.se
