Nebojsa44/Instrumented-platform/PDF/O-1637-008.PDF

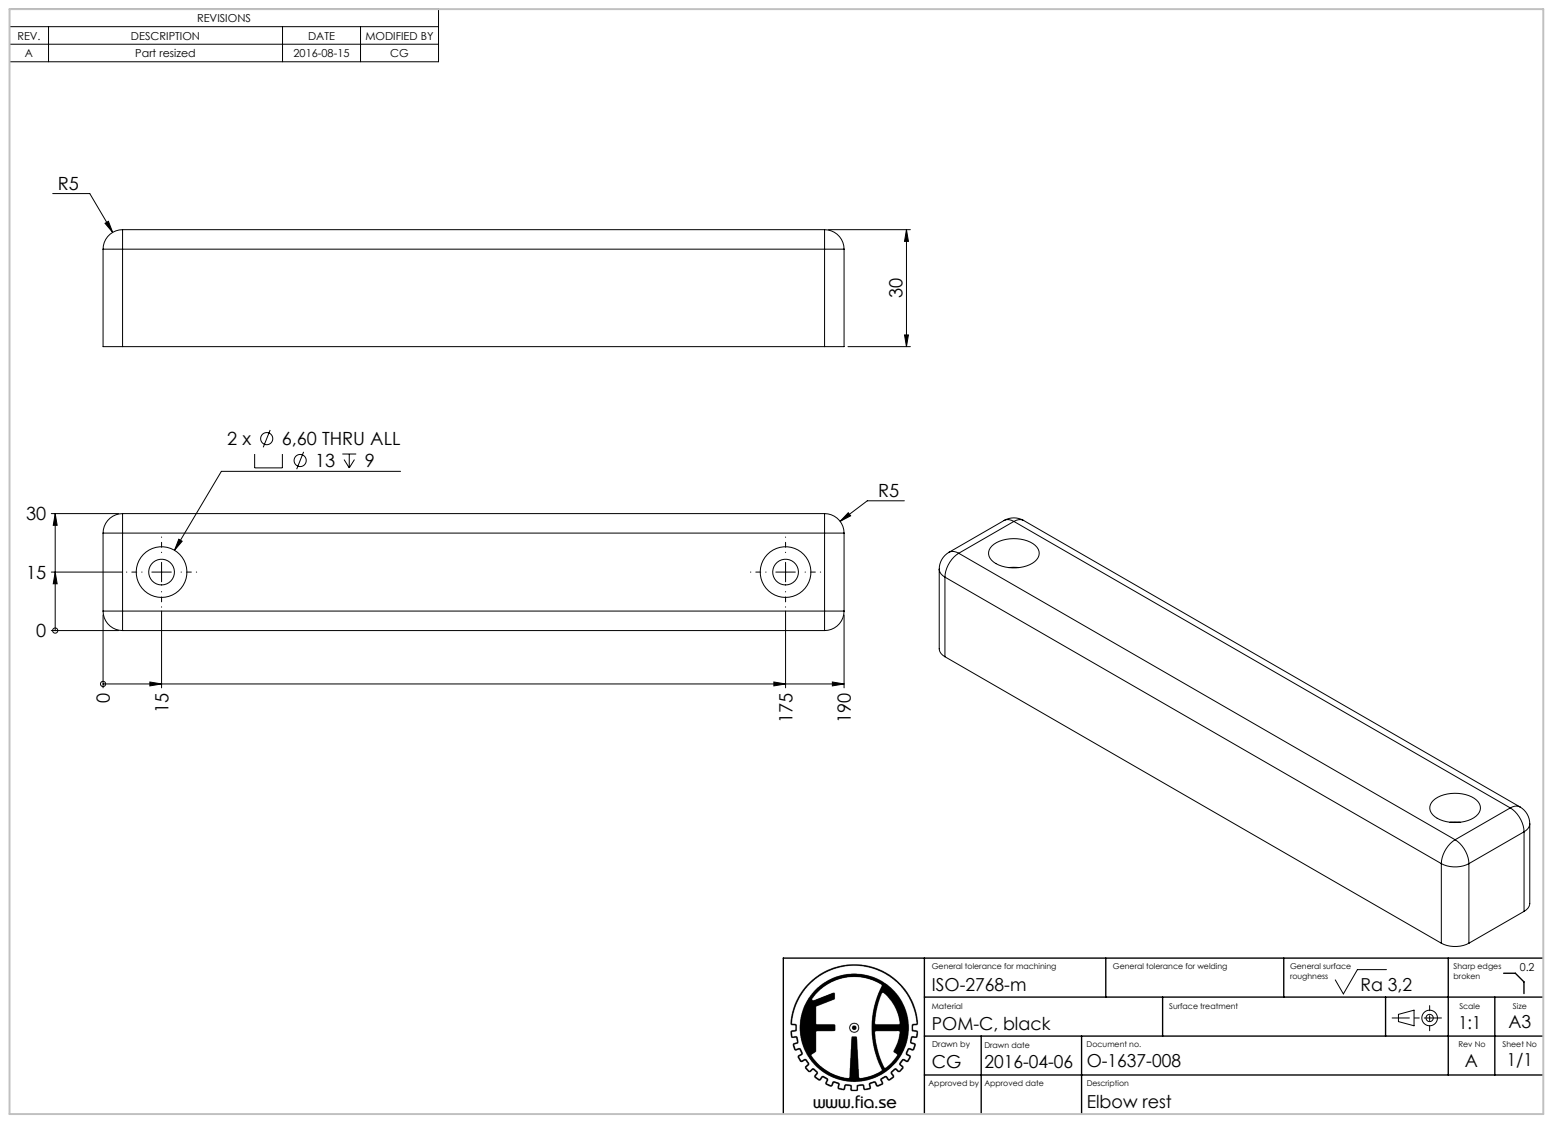
[picture p39: page 1]
6,60 THRU ALL; Elbow rest; Rev No; Approved by; Drawn by; Sheet No; Document no.; Sharp edges; Drawn date; Approved date; Surface treatment; General surface

REVISIONS

REV. | DESCRIPTION | DATE | MODIFIED BY
A | Part resized | 2016-08-15 | CG

General tolerance for machining
ISO-2768-m
POM-C, black

General tolerance for welding

www.fia.se
