Nebojsa44/Instrumented-platform/PDF/O-1637-010.PDF

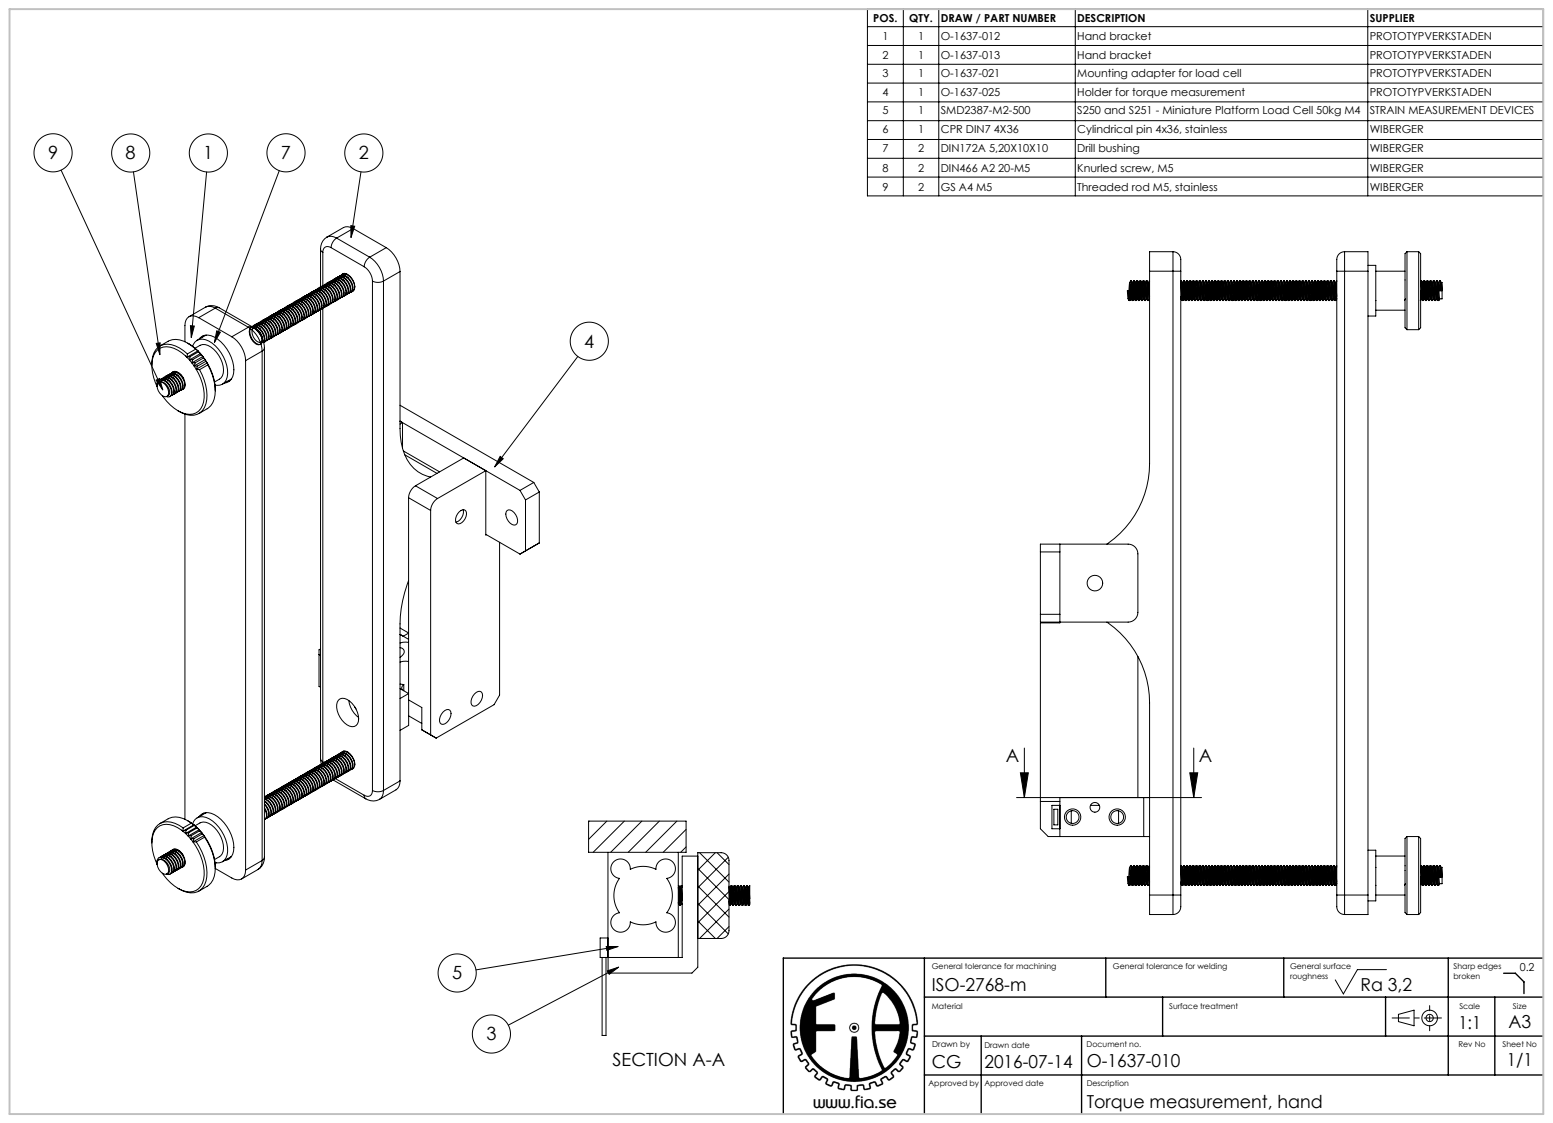
[picture p40: page 1]
SECTION A-A; Rev No; Approved by; Drawn by; Sheet No; Sharp edges; Drawn date CG 2016-07-14; Approved date; Surface treatment; General surface

POS. | QTY. | DRAW / PART NUMBER | DESCRIPTION | SUPPLIER
1 | 1 | O-1637-012 | Hand bracket | PROTOTYPVERKSTADEN
2 | 1 | O-1637-013 | Hand bracket | PROTOTYPVERKSTADEN
3 | 1 | O-1637-021 | Mounting adapter for load cell | PROTOTYPVERKSTADEN
4 | 1 | O-1637-025 | Holder for torque measurement | PROTOTYPVERKSTADEN
5 | 1 | SMD2387-M2-500 | S250 and S251 - Miniature Platform Load Cell 50kg M4 | STRAIN MEASUREMENT DEVICES
6 | 1 | CPR DIN7 4X36 | Cylindrical pin 4x36, stainless | WIBERGER
7 | 2 | DIN172A 5,20X10X10 | Drill bushing | WIBERGER
8 | 2 | DIN466 A2 20-M5 | Knurled screw, M5 | WIBERGER
9 | 2 | GS A4 M5 | Threaded rod M5, stainless | WIBERGER

General tolerance for machining
ISO-2768-m

General tolerance for welding

Document no.
Torque measurement, hand

www.fia.se
