Nebojsa44/Instrumented-platform/PDF/O-1637-012.PDF

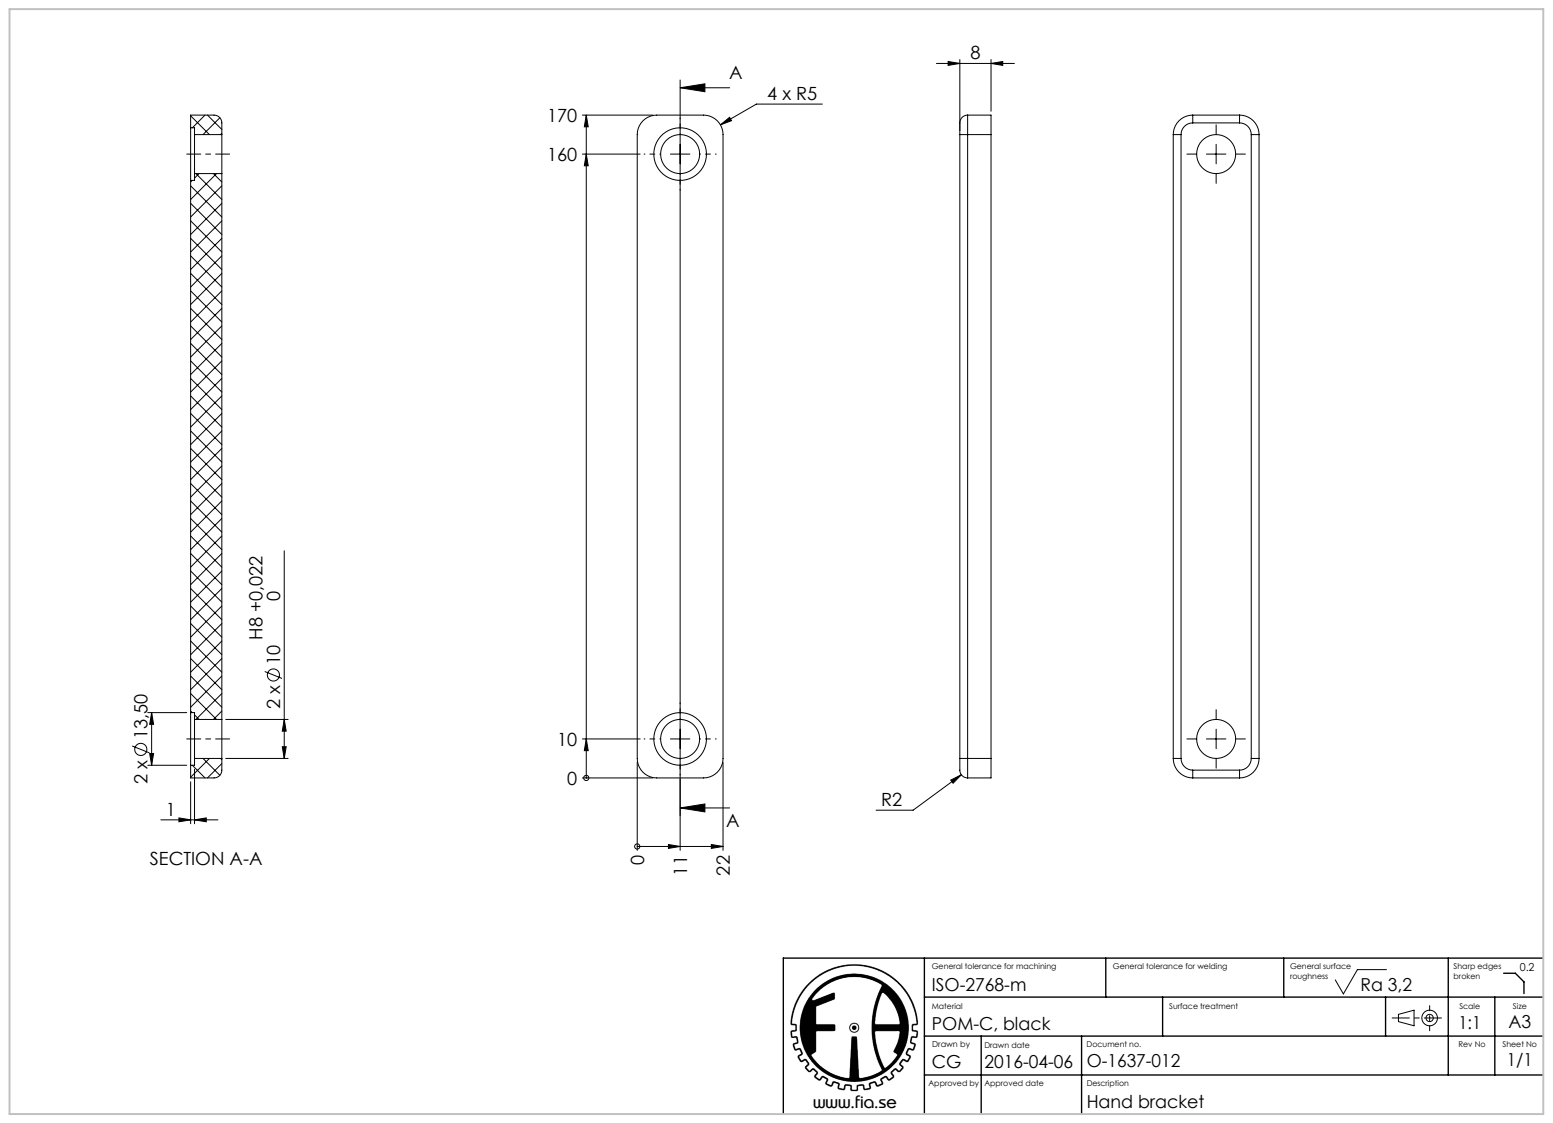
[picture p41: page 1]
SECTION A-A; Hand bracket; Rev No; Approved by; Drawn by; Sheet No; Document no.; Sharp edges; Drawn date; Approved date; Surface treatment; General surface

General tolerance for machining
ISO-2768-m
POM-C, black

General tolerance for welding

www.fia.se
