Nebojsa44/Instrumented-platform/PDF/O-1637-013.PDF

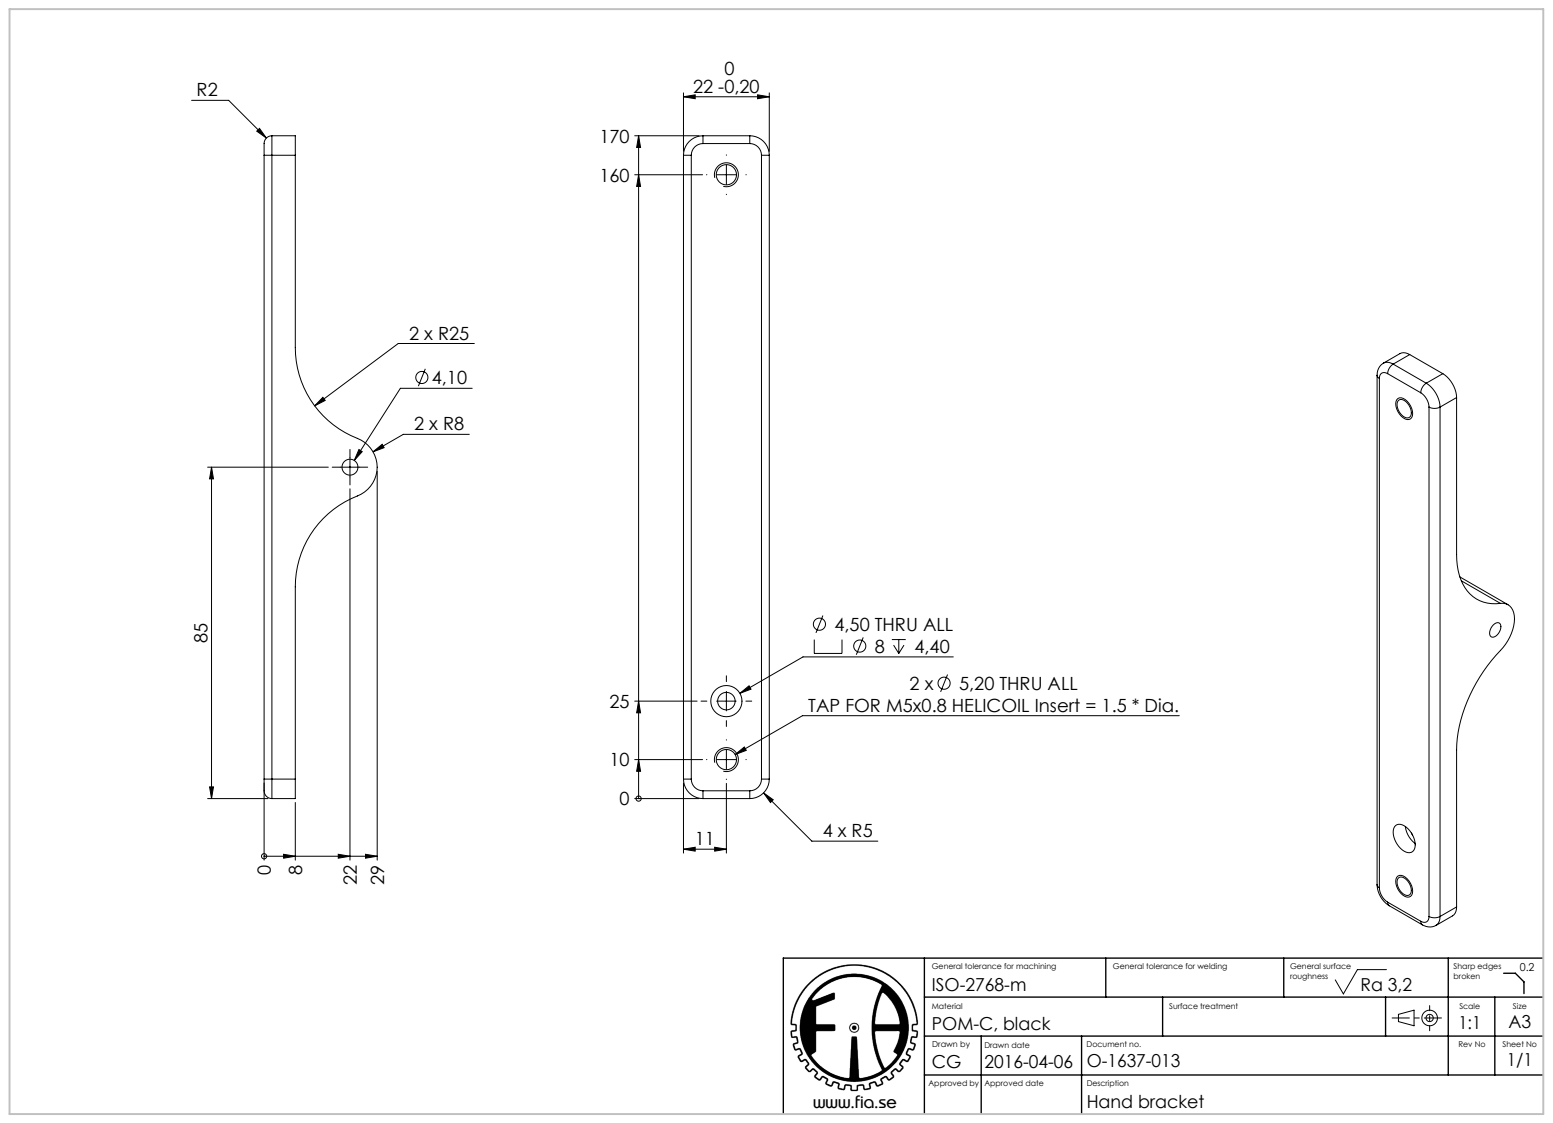
[picture p42: page 1]
4,50 THRU ALL 8 4,40 2 x 5,20 THRU ALL; Hand bracket; Rev No; Approved by; Drawn by; Sheet No; Document no.; Sharp edges; Drawn date; Approved date; Surface treatment; General surface

TAP FOR M5x0.8 HELICOIL Insert = 1.5 * Dia.

General tolerance for machining
ISO-2768-m
POM-C, black

General tolerance for welding

www.fia.se
