Nebojsa44/Instrumented-platform/PDF/O-1637-016.PDF

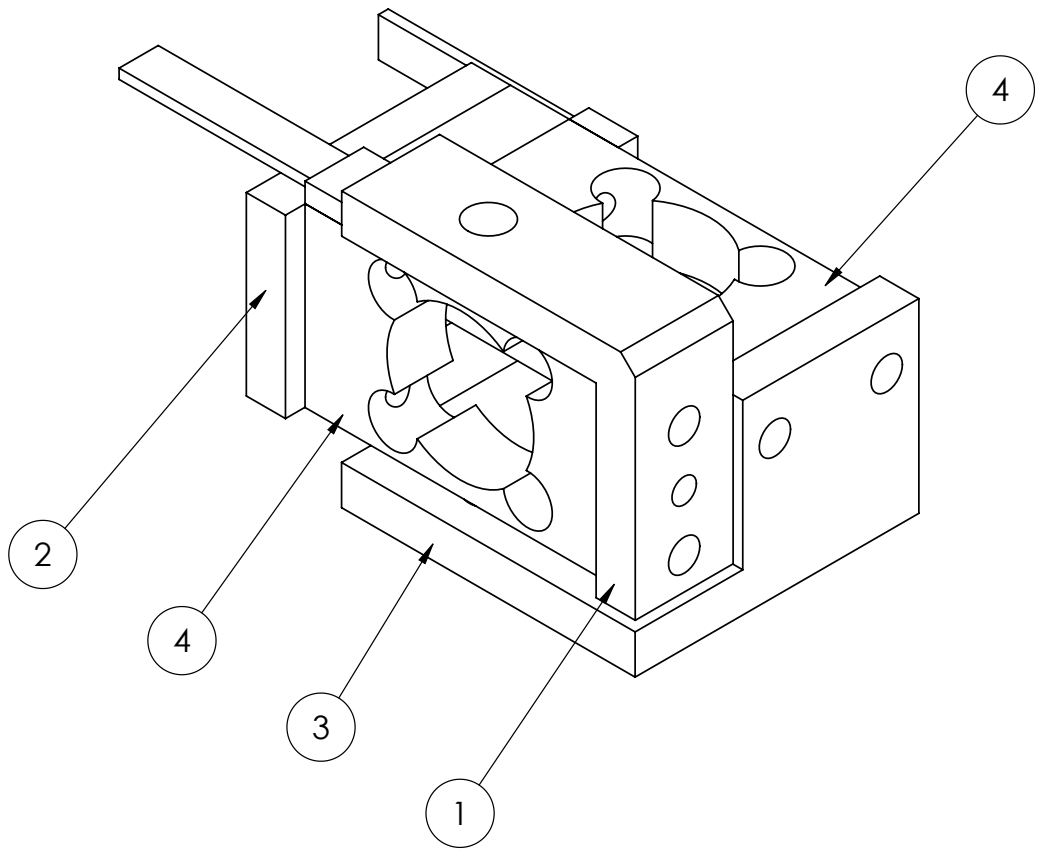
[picture p43: page 1]
Measurement unit; Rev No; Approved by; Drawn by; Sheet No; Document no.; Sharp edges; Drawn date CG 2016-06-30; Approved date; Surface treatment; General surface

POS. | QTY. | DRAW / PART NUMBER | DESCRIPTION | SUPPLIER
1 | 1 | O-1637-004 | Mounting adapter for load cell | PROTOTYPVERKSTADEN
2 | 1 | O-1637-015 | Mounting adapter for load cell | PROTOTYPVERKSTADEN
3 | 1 | O-1637-017 | Mounting adapter for load cell | PROTOTYPVERKSTADEN
4 | 2 | SMD2387-M2-100 | S250 and S251 - Miniature Platform Load Cell 10kg M3 | STRAIN MEASUREMENT DEVICES

General tolerance for machining
ISO-2768-m

General tolerance for welding

www.fia.se
