Nebojsa44/Instrumented-platform/PDF/O-1637-018.PDF

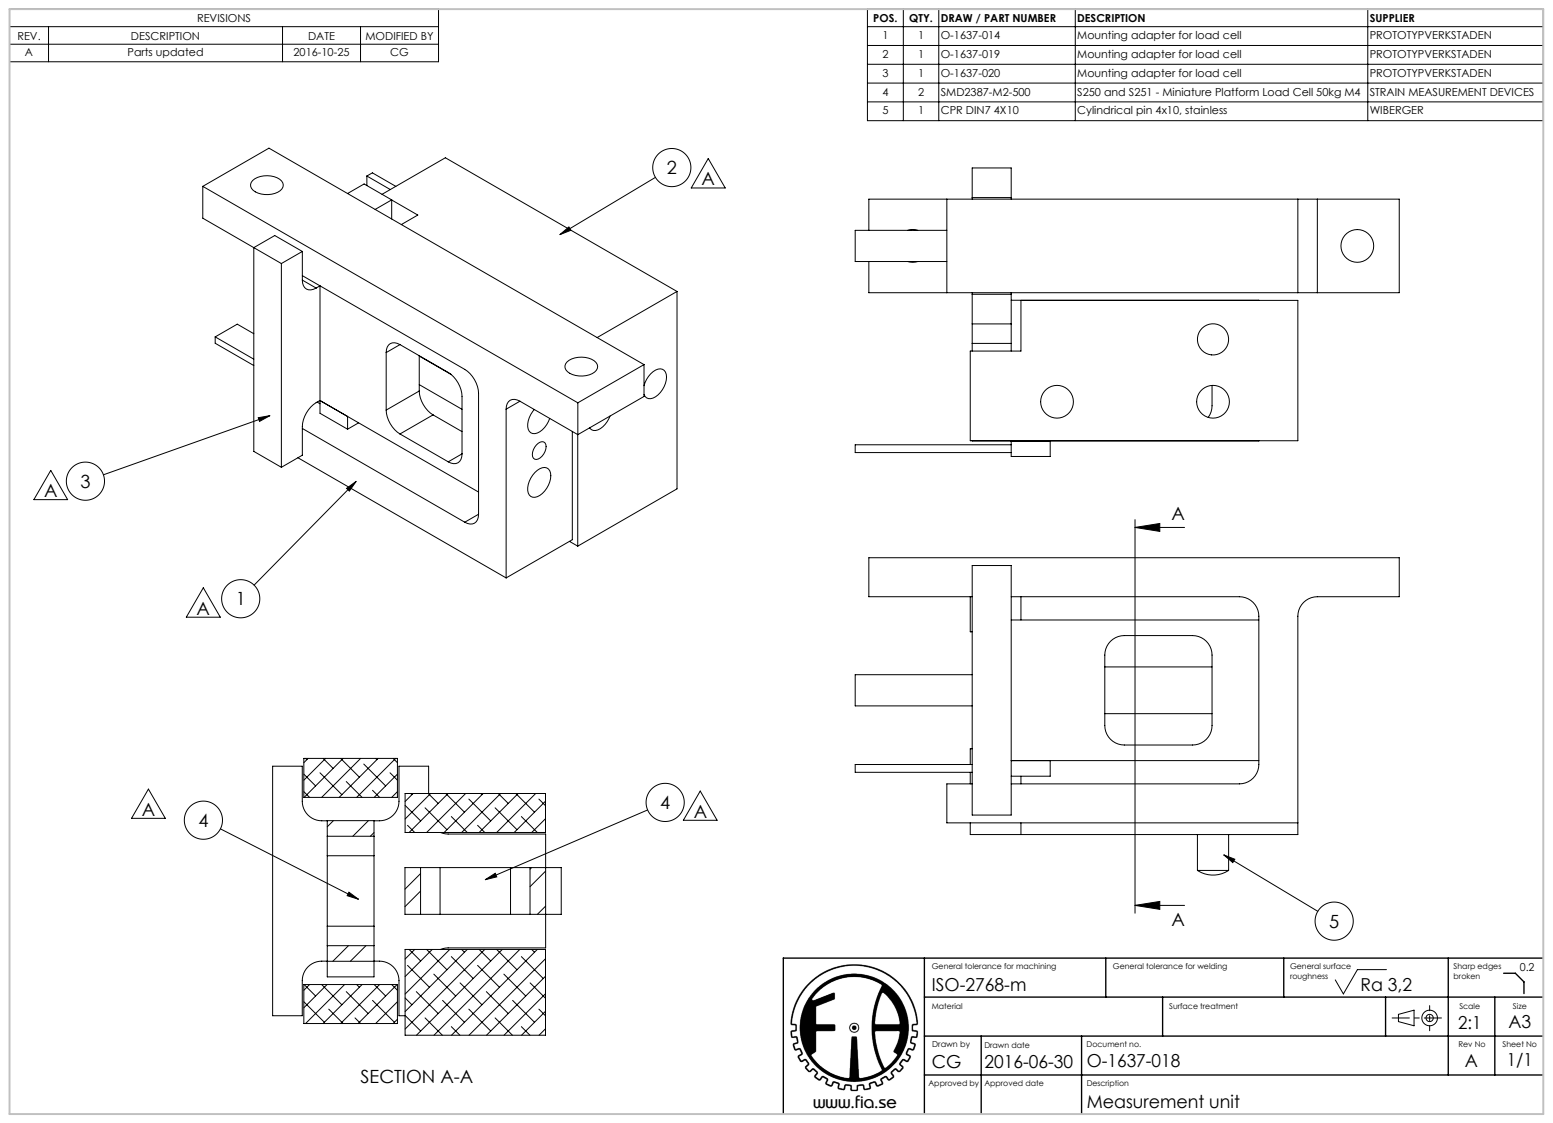
[picture p44: page 1]
SECTION A-A; Measurement unit; Rev No; Approved by; Drawn by; Sheet No; Document no.; Sharp edges; Drawn date CG 2016-06-30; Approved date; Surface treatment; General surface

REVISIONS | | POS. | QTY. | DRAW / PART NUMBER | DESCRIPTION | SUPPLIER

REV. | DESCRIPTION | DATE | MODIFIED BY | | 1 | 1 | O-1637-014 | Mounting adapter for load cell | PROTOTYPVERKSTADEN
A | Parts updated | 2016-10-25 | CG | | 2 | 1 | O-1637-019 | Mounting adapter for load cell | PROTOTYPVERKSTADEN

3 | 1 | O-1637-020 | Mounting adapter for load cell | PROTOTYPVERKSTADEN
4 | 2 | SMD2387-M2-500 | S250 and S251 - Miniature Platform Load Cell 50kg M4 | STRAIN MEASUREMENT DEVICES
5 | 1 | CPR DIN7 4X10 | Cylindrical pin 4x10, stainless | WIBERGER

General tolerance for machining
ISO-2768-m

General tolerance for welding

www.fia.se
