Nebojsa44/Instrumented-platform/PDF/O-1637-019.PDF

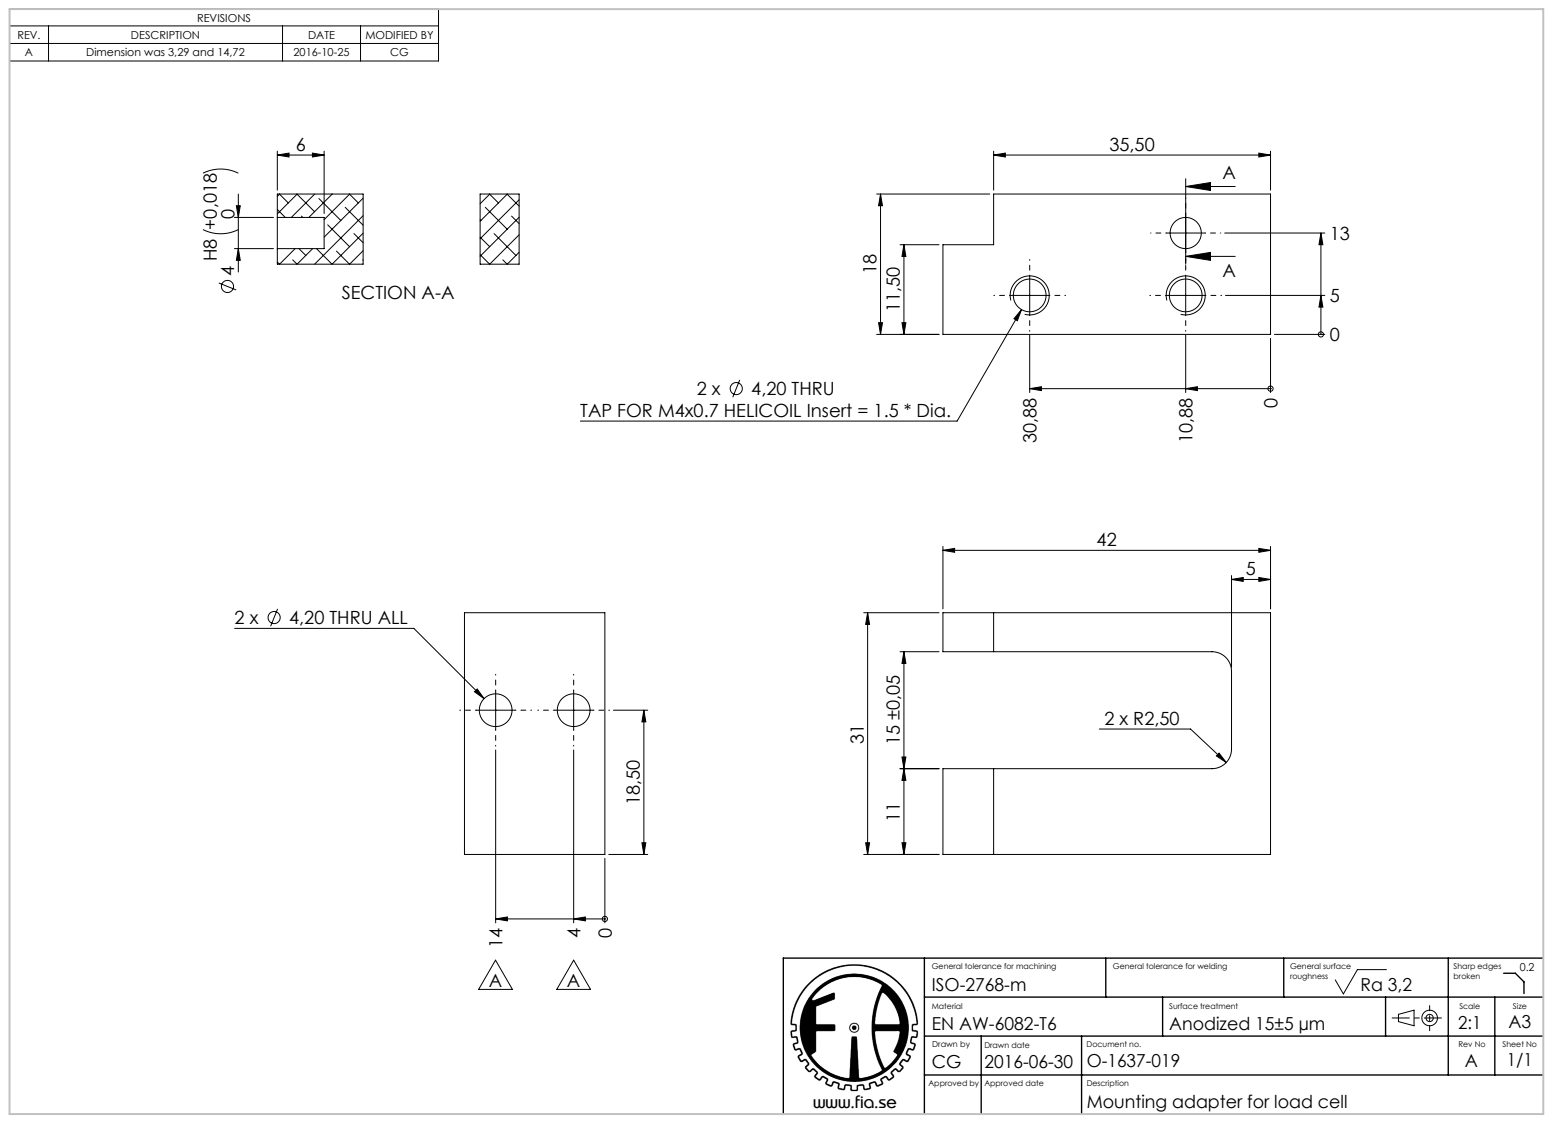
[picture p45: page 1]
4,20 THRU ALL; 4,20 THRU; SECTION A-A; Rev No; Approved by; Drawn by; Sheet No; Sharp edges; Drawn date; Approved date; Surface treatment Anodized 15±5 µm; General surface

REVISIONS | 35,50

REV. | DESCRIPTION | DATE | MODIFIED BY
A | Dimension was 3,29 and 14,72 | 2016-10-25 | CG

TAP FOR M4x0.7 HELICOIL Insert = 1.5 * Dia.

General tolerance for machining
ISO-2768-m

General tolerance for welding

Document no.
Mounting adapter for load cell

www.fia.se
