Nebojsa44/Instrumented-platform/PDF/O-1637-021.PDF

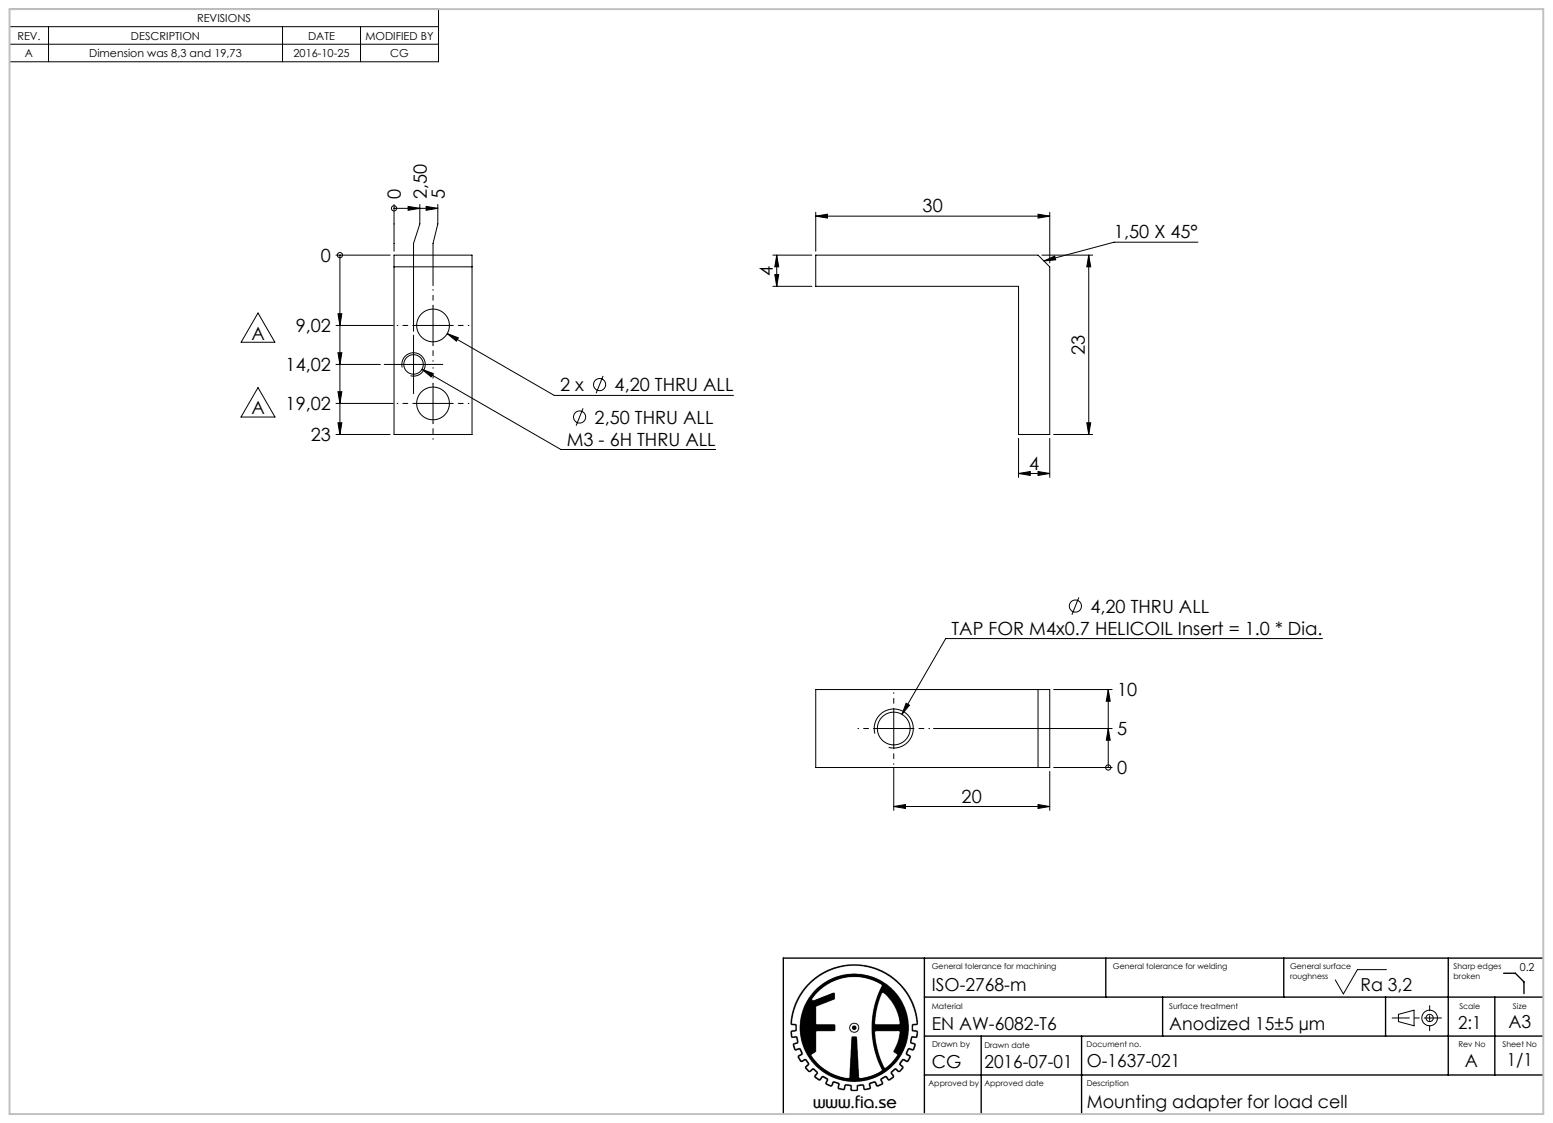
[picture p46: page 1]
4,20 THRU ALL; 2,50 THRU ALL M3 - 6H THRU ALL; Rev No; Approved by; Drawn by; Sheet No; Sharp edges; Drawn date; Approved date; Surface treatment Anodized 15±5 µm; General surface

REVISIONS | 30

REV. | DESCRIPTION | DATE | MODIFIED BY
A | Dimension was 8,3 and 19,73 | 2016-10-25 | CG

TAP FOR M4x0.7 HELICOIL Insert = 1.0 * Dia.

General tolerance for machining
ISO-2768-m

General tolerance for welding

Document no.
Mounting adapter for load cell

www.fia.se
