Nebojsa44/Instrumented-platform/PDF/O-1637-025.PDF

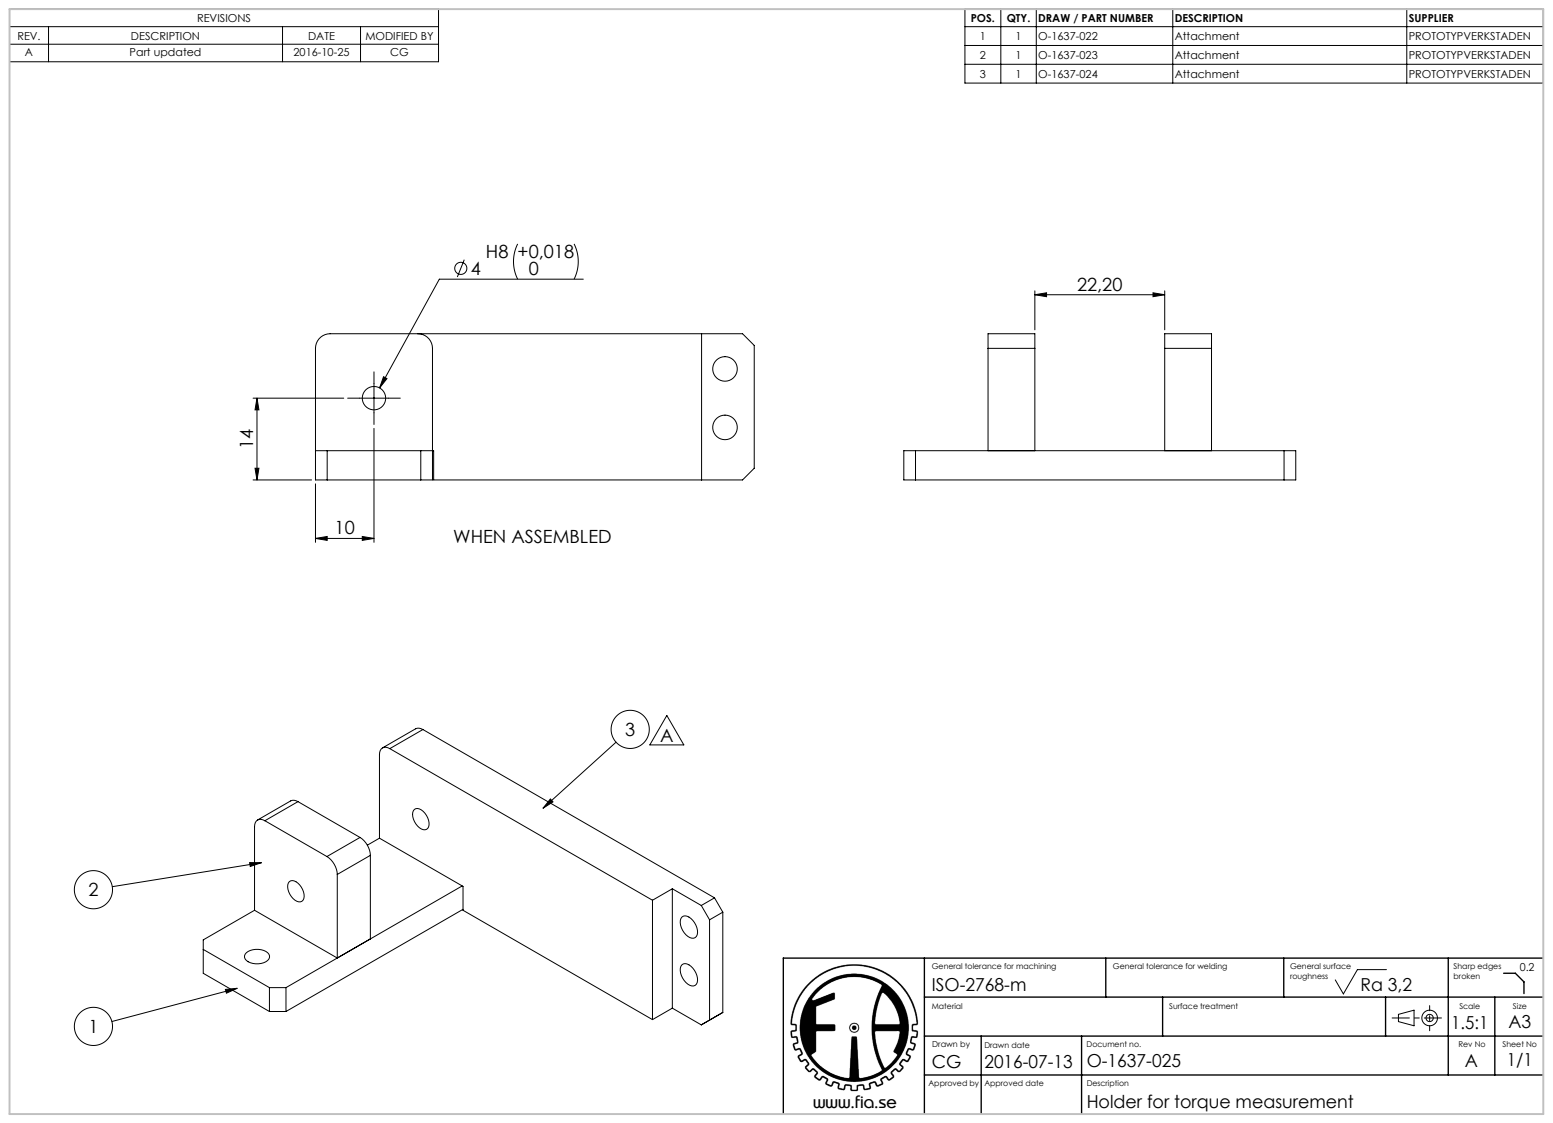
[picture p47: page 1]
WHEN ASSEMBLED; Rev No; Approved by; Drawn by; Sheet No; Sharp edges; Drawn date CG 2016-07-13; Approved date; Surface treatment; General surface

REVISIONS | | POS. | QTY. | DRAW / PART NUMBER | DESCRIPTION | SUPPLIER

REV. | DESCRIPTION | DATE | MODIFIED BY | | 1 | 1 | O-1637-022 | Attachment | PROTOTYPVERKSTADEN
A | Part updated | 2016-10-25 | CG | | 2 | 1 | O-1637-023 | Attachment | PROTOTYPVERKSTADEN

3 | 1 | O-1637-024 | Attachment | PROTOTYPVERKSTADEN

General tolerance for machining
ISO-2768-m

General tolerance for welding

Document no.
Holder for torque measurement

www.fia.se
