Nebojsa44/Instrumented-platform/PDF/O-1637-035.PDF

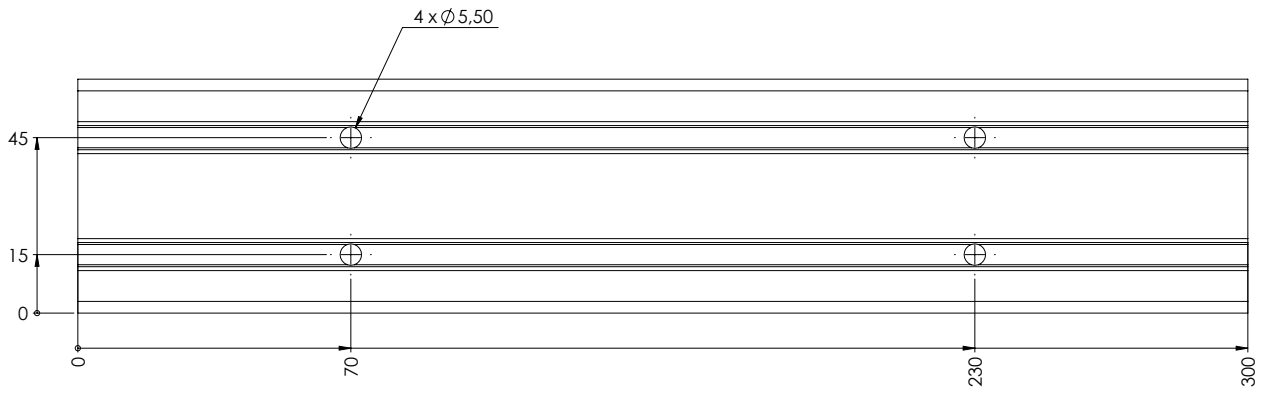
[picture p48: page 1]
Profile 6 60x30 light; Rev No; Approved by; Drawn by; Sheet No; Document no.; Sharp edges; Drawn date; Approved date; Surface treatment; General surface

REVISIONS

REV. | DESCRIPTION | DATE | MODIFIED BY
A | Change of material | 2016-08-15 | CG

General tolerance for machining
ISO-2768-m

General tolerance for welding

www.fia.se
